DSeabra/headphone_amp/notes/Guitar Headphone Amp/References.md

## Battery charging
- [Microchip MCP73831 Single-Cell Charging Chip](https://cdn.sparkfun.com/datasheets/Components/General%20IC/33244_SPCN.pdf)
	- Sparkfun sells these boards implementing this design:
		- [Single cell, no frills](https://www.sparkfun.com/sparkfun-usb-lipoly-charger-single-cell.html)
		- [Programmable output current single cell](https://www.sparkfun.com/sparkfun-adjustable-lipo-charger.html)
- Sparkfun Lithium-Ion [400mAh pouch](https://www.sparkfun.com/lithium-ion-battery-400mah.html)
- Sparkfun Lithium-Ion [950mAh pouch](https://www.sparkfun.com/lithium-ion-battery-850mah.html)
- Sparkfun ["LiPower" Buck/Boost](https://www.sparkfun.com/lipower-boost-converter.html)

- Adafruit [Universal USB / DC / Solar Lithium Ion/Polymer charger - bq24074](https://www.adafruit.com/product/4755)

# BQ24074 Design Notes

Enable settings
![[Pasted image 20260809201506.png]]

~CHG behavior: 280K pull-down but do NOT leave this disconnected!
