DSeabra/headphone_amp/notes/Guitar Headphone Amp/Charts/pot-taper.png

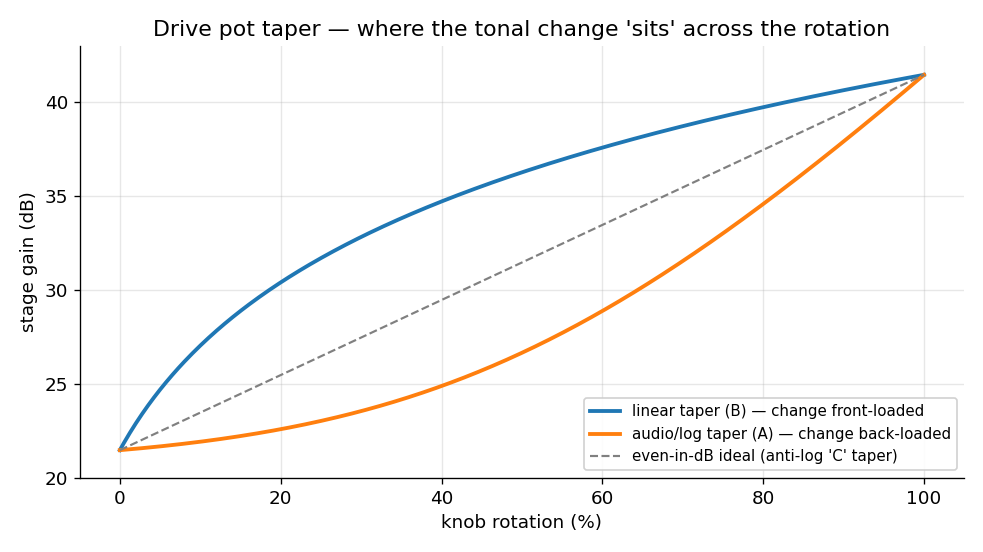
notes/Guitar Headphone Amp/Charts/pot-taper.png
