DSeabra/headphone_amp/notes/Guitar Headphone Amp/Guitar-Headphone-Amp-Theory-of-Operation.md

---
title: Guitar Headphone Amp — Theory of Operation & Tuning Guide
project: pocket guitar headphone amp (rev A)
status: design in progress
tags: [electronics, analog, guitar, distortion, app-note]
---

# Guitar Headphone Amp — Theory of Operation & Tuning Guide

> [!abstract] What this document is
> A working explanation of *why* each part of the amp is shaped the way it is, and *which knobs (literal and component) change what*. It is meant to be read alongside the schematic, so that tuning rev A is informed guessing rather than blind swapping. Values given are **starting points** anchored to the Tube-Screamer (TS) gain-stage lineage — the most-measured drive circuit in guitar electronics — chosen so you tune *from* a known-good baseline.

---

## 1. System overview

The signal path is deliberately split by **impedance**: a FET-input stage where the source impedance is high (the guitar), and a bipolar-input driver where it is low (the headphones). Everything runs off a single boosted 9 V rail with a synthesized mid-rail so the op-amps see a symmetric ±4.5 V about the audio "ground."

Full system block diagram

```mermaid
flowchart TB
    G["guitar<br/>(passive pickup)"] --> IN["1/4&quot; TRS jack"]
    IN --> DRV["OPA1678-A<br/>DRIVE stage<br/>(hi-Z in + gain + clip)"]
    DRV --> REC["OPA1678-B<br/>recovery / make-up gain"]
    REC --> MV["master volume<br/>(pot → mid-rail)"]
    MV --> BL["OPA1622-L<br/>unity buffer"]
    MV --> BR["OPA1622-R<br/>unity buffer"]
    BL --> CL["coupling cap L<br/>220 µF polymer"]
    BR --> CR["coupling cap R<br/>220 µF polymer"]
    CL --> HP["3.5 mm TRS<br/>tip = L / ring = R<br/>(32 Ω ×2)"]
    CR --> HP

    subgraph PWR [power]
      direction LR
      USB["USB-C"] --> CHG["power-path charger"] --> SYS["SYS node"]
      CELL["Li-ion cell"] --- CHG
      SYS --> BST["boost → 9 V"] --> SPL["TLE2426<br/>rail splitter"]
      SPL --> MID["virtual GND = 4.5 V"]
    end

    MID -.mid-rail ref.-> DRV
    MID -.mid-rail ref.-> REC
    MID -.vol return + OPA1622 GND.-> MV
    BST -.+9 V.-> BL
    BST -.+9 V.-> BR
```

> The signal is **mono** through the drive and volume stages, then **fans out to L/R stereo** at the OPA1622 buffers — one per earpiece, each into its own coupling cap and the tip/ring of the TRS jack.

The three most important architectural decisions and their reasons:

- **Boost to a regulated 9 V (no LDO).** A single Li-ion cell sags from 4.2 V to 3.0 V, which is *below* the OPA1622's 4 V floor for most of its life. Regulating *up* keeps every stage in-spec regardless of charge state and gives constant tone (the clip threshold no longer drifts as the battery drains). We picked **9 V specifically for input headroom**: on a 6 V rail the OPA1678's input common-mode window reaches only ~1 V above mid-rail, so a hard humbucker transient can graze the top of it; 9 V opens that to ~2.5 V, clearing the hottest pickups (see §2.8). Both op-amps run to 36 V, so the higher rail changes **no parts**, and it still leaves the boost a clean step-up ratio from any source.
- **Virtual ground instead of a true negative rail.** We only need a *reference* at mid-supply, not a second regulated rail. The TLE2426 synthesizes 4.5 V with milliohm output impedance. Signals are AC-coupled around it, so the headphone return current goes to battery-negative, **not** through the mid-rail — keeping the reference quiet.
- **FET input, bipolar output.** A passive pickup must see ≥ 1 MΩ or it loses treble; a bipolar input's ~µA bias current across 1 MΩ would create ~volts of offset. So the front end is FET (pA bias). The headphone load needs current, which bipolar output stages deliver with low distortion — hence the OPA1622 at the low-impedance end.

> [!info] Companion docs
> Component-level wiring lives in the **[[Connectivity-Netlist]]** companion (per-stage netlist tables). The figure above is `system-block-diagram.svg`.

---

## 2. The input & drive stage — the heart of the tone

This one op-amp does three jobs at once: **present a high-impedance input**, **amplify**, and **clip**. Understanding how those coexist is most of understanding the amp.

### 2.1 Why non-inverting = high-Z for free

In a non-inverting amp the signal enters the **+ input**, which only ever sees the bias resistor to ground. The gain-setting network hangs off the **– input**, on the op-amp's side of the loop. So the pickup never "sees" the gain resistors — input impedance and gain are set at two different nodes and don't trade against each other. That is why we don't need a separate unity-gain buffer: a non-inverting gain stage *is already* a buffer that happens to also amplify.

### 2.2 The feedback network is five parts, not one

```mermaid
flowchart TB
    OUT["op-amp output"] -->|feedback leg| N1["Rf_fixed 51k + DRIVE pot 500k"]
    N1 --> MINUS["– input"]
    DIODES["clip diodes (socketed)"] --- OUT
    DIODES --- MINUS
    CFB["C_fb ~51 pF (high-cut)"] --- OUT
    CFB --- MINUS
    MINUS --> RG["Rg 4.7k"]
    RG --> CG["C_g 47 nF (DC-block + low-cut)"]
    CG --> MID["mid-rail 4.5 V"]
```

| Part | Value (start) | Job |
|---|---|---|
| `R_bias` (R13) | 1 MΩ to mid-rail | high-Z input + DC bias to 4.5 V |
| `C_in` (C2, series at input) | 0.1 µF PEN film | blocks the pickup's DC path so it can't fight the 4.5 V bias; ~1.6 Hz corner |
| `R_series` (R10) + `C_rf` (C3) | 1 kΩ + 470 pF NP0 | defined ~340 kHz RF/hum roll-off + input protection |
| `Rg` (R12) | 4.7 kΩ | lower leg of the gain divider (sets the floor) |
| `C_g` (C5, series with Rg) | 47 nF | **DC-block** (gain = 1 at DC) + **low-cut** ≈ 720 Hz |
| `Rf_fixed` (R11) | 51 kΩ | bounds the top; sets minimum (cleanest) gain |
| `DRIVE pot` (via J4) | 500 kΩ linear | the amount-of-dirt control |
| `C_fb` (C4) | 51 pF NP0 | **high-cut**; tames fizz/RF, aids stability |
| clip diodes (socket J7) | 2× 1N4148 | soft-clip across the feedback leg |

### 2.3 The gain equation

Above the capacitor corners (i.e. in the audio midband), the stage is a plain non-inverting amp:

$$
A_v \;=\; 1 + \frac{R_{f,\text{fixed}} + R_{\text{pot}}}{R_g}
$$

With the starting values:

$$
A_{v,\text{min}} = 1 + \frac{51\text{k}}{4.7\text{k}} \approx 12\;(21\,\text{dB}),
\qquad
A_{v,\text{max}} = 1 + \frac{551\text{k}}{4.7\text{k}} \approx 118\;(41\,\text{dB})
$$

…about a **20 dB drive range**. Turning the pot doesn't change the clip *ceiling* — it changes how hard the signal slams into the diodes, i.e. how much of the waveform gets clipped and how early.

### 2.4 Why there's a capacitor in series with Rg (the load-bearing trick)

`C_g` does two things at once:

1. **DC stability.** At DC the cap is open, so `Zg → ∞` and the gain collapses to **1**. That means the amplified input offset can't slam the output to a rail — the stage passes the 4.5 V bias straight through at unity and only develops gain for AC. Omit this cap and the stage rails on its own offset at high drive.
2. **Bass tightening.** The corner $f = \tfrac{1}{2\pi R_g C_g} = \tfrac{1}{2\pi (4.7\text{k})(47\text{n})} \approx 720\text{ Hz}$ means low frequencies see *less* gain than mids. Thinning the bass **before** the clipper is what keeps distorted chords tight instead of turning to mush (low notes otherwise dominate the clipping and intermodulate).

### 2.5 Why the treble rolls off *more* as you crank

`C_fb` across the feedback creates a high-cut at $f = \tfrac{1}{2\pi R_f C_{fb}}$. But `R_f` grows with the drive pot, so the corner **moves down** as you add gain:

- Drive min: $R_f = 51\text{k} \Rightarrow \approx 61\text{ kHz}$ (bright)
- Drive max: $R_f = 551\text{k} \Rightarrow \approx 5.7\text{ kHz}$ (darker)

This is why a TS-style circuit smooths and thickens as you crank it — it's not a side effect, it's the mechanism. Putting §2.4 and §2.5 together gives the stage's actual frequency response:

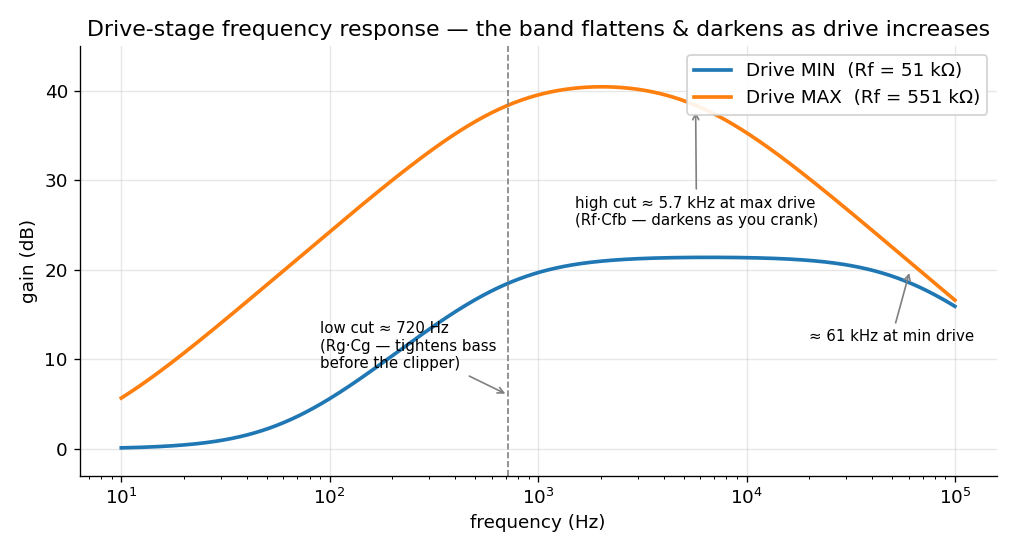
[picture p2: notes/Guitar Headphone Amp/Charts/drive-freq-response.png]
Drive-stage frequency response


Read this as: a **band** whose bottom is fixed at ~720 Hz and whose top slides *down* as you add drive. The midband gain rises (12× → 118×) and the treble corner falls (61 kHz → 5.7 kHz) simultaneously.

### 2.6 How the diodes clip

Two anti-parallel diodes sit across the feedback leg. While the output stays below a diode's forward voltage `Vf`, the diodes are open and the stage has its full gain. Once the output tries to exceed ±`Vf`, a diode conducts, shunting feedback current and dropping the incremental gain toward ~1 — so the output *soft-limits* around ±`Vf`. Because the knee is set by the diode's exponential I–V curve, the corners are rounded, not square: this is **soft clipping**.

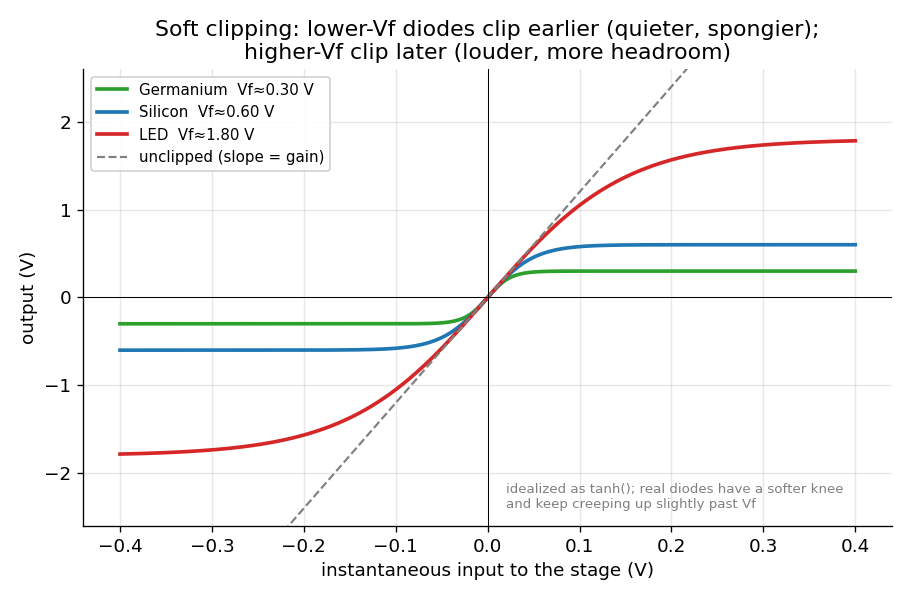
[picture p3: notes/Guitar Headphone Amp/Charts/clipping-transfer.png]
Soft-clip transfer curves for different diode types


The diode's `Vf` sets the clip threshold, which sets both **loudness** and **feel**:

- **Germanium (~0.3 V):** clips earliest → quiet, spongy, "compressed" — least headroom.
- **Silicon 1N4148 (~0.6 V):** the classic TS voice — moderate, singing.
- **LED (~1.8 V):** clips latest → loud, open, more dynamic, closer to the rails.

> [!note] Idealization
> The curves above are drawn as `tanh()` for clarity. Real diodes have a slightly softer knee and keep creeping upward past `Vf` (they never perfectly clamp), which is part of why real clipping sounds "alive." Trust the *ordering and spacing* of the thresholds, not the exact flat tops.

### 2.7 Symmetric vs asymmetric — where the harmonics come from

A **symmetric** clip (equal top and bottom) produces mostly **odd** harmonics — the fizzy, "solid-state" character. Making the clip **asymmetric** (e.g. 1 diode one way, 2 the other, so the two sides clip at different thresholds) adds **even** harmonics, which the ear reads as warmer and more "tube-like."

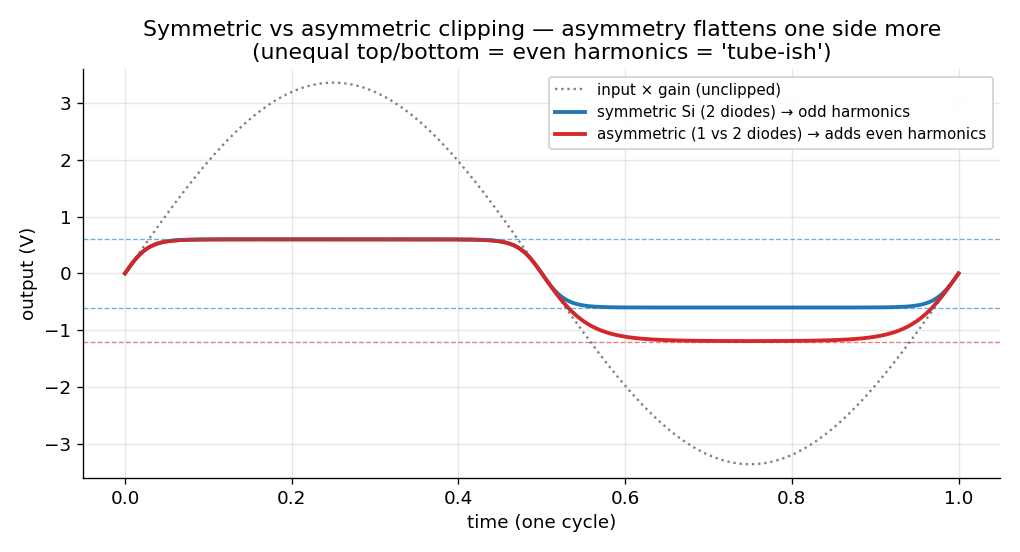
[picture p4: notes/Guitar Headphone Amp/Charts/clipping-waveforms.png]
Symmetric vs asymmetric clipped waveforms


Notice the asymmetric trace flattens one polarity more than the other — that top/bottom inequality *is* the even-harmonic content. This is the single cheapest tone change you can make, and it's why the diodes are socketed.

> [!tip] How the socket actually works (rev A)
> The feedback clipper is a **Mill-Max socket** (`J7`, two rows of four) with a **0 Ω link (`JP1`/`JP2`) populated on each row by default**. Default = one silicon diode per direction → **symmetric**. To go **asymmetric**, pull the 0 Ω on one side and plug a *second* diode into that row's spare holes (two in series → higher Vf that direction). Diode *type* swaps (Si / Ge / Schottky / LED) are just pull-and-replace. The silkscreen marks anode direction per row — mind orientation when inserting an anti-parallel pair.

### 2.8 The optional input soft-limiter (Ihsan's idea)

This is a *different* clipper doing the *opposite* job at the *opposite* end of the stage, and it's worth understanding as its own thing.

The feedback diodes (§2.6) clip the **amplified** signal, *after* gain — that's the distortion voicing. The **input soft-limiter** is an optional second anti-parallel pair at the very **input**, from `FIRST_STAGE_IN` to mid-rail, *before* any gain. It doesn't shape distortion; it **tames the raw guitar transient** — the fast, multi-volt spike a hard-struck humbucker throws before the note settles.

**Why it exists (and why 9 V made it optional rather than mandatory).** The drive op-amp's + input has a finite common-mode window — on 9 V, about 4.5 V ± 2.5 V. A very hot pickup, hit hard, can briefly push the + input past the top of that window. The OPA1678 has no phase reversal, so it just soft-limits gracefully — but you'd rather not lean on that. Clamping the raw input to `VMID ± Vf` keeps the signal inside the CM window *by construction*, and as a bonus adds a gentle **compression** on the loudest peaks — the "smooths the tops even at low drive" behaviour Ihsan described. Because the clamp sits *before* gain, it works at any drive setting, including diodes-out clean-boost mode.

**Vf sets how much it does:**
- **Higher Vf (LED ~1.8 V, or two Si in series ~1.2 V)** — catches only the biggest transients; sits below the ~2.5 V CM ceiling but above normal playing, so it protects the input and lightly compresses without audibly squashing. The "insurance + subtle tamer" setting, and where I'd start.
- **Lower Vf (single Si ~0.6 V, Ge ~0.3 V)** — clamps early and hard; now it's a deliberate **input compressor/limiter** that squashes dynamics before the dirt. A real effect, but a strong one.

**Wiring:** anti-parallel pair from `FIRST_STAGE_IN` (the node *after* `C_in`, i.e. the AC signal riding on mid-rail) to `VMID`. It is **not in the rev-A netlist yet** — provision it as a socketed / DNP pair (same swap logic as the feedback clipper) so you can audition it, or leave the footprint empty. On 9 V you may decide you never need it — which is exactly why it's a provision, not a commitment.

> [!note] Why it's at the input, not the output
> Ihsan's first instinct was to use the *final* drive stage's diodes as the transient tamer. But those feedback diodes clamp relative to the *post-gain* signal and don't care about the rail — so rail voltage can't give them "room" to gently limit an *input* transient. The raw transient only exists *at the input*, so that's where a soft-limiter has to live to do the job he described. Same idea, correct location.

---

## 3. The drive pot taper (corrected — see the working)

An earlier pass through this doc claimed **even-in-dB gain over rotation would need an anti-log ("C") taper**, and that standard audio/log ("A") taper would be back-loaded. That claim doesn't survive actually running the numbers on this circuit's own gain equation (§2.3), and a side-by-side read of the real Bourns PDB181-GTR datasheet confirms the fix. Correcting it here rather than leaving it stand.

**The gain equation, worked as a function of rotation.** From §2.3:

$$A_v(\theta) = 1 + \frac{R_{f,fixed} + R_{pot}(\theta)}{R_g} = 1 + \frac{51\text{k} + R_{pot}(\theta)}{4.7\text{k}}$$

Gain in dB is $20\log_{10}(A_v)$. For that to be **linear in rotation** — i.e. an even-feeling dB sweep — $A_v(\theta)$ itself has to be **exponential** in rotation, which means $R_{pot}(\theta)$ has to be exponential too. Solving for the curve that lands on this circuit's own endpoints (0 Ω → 500 kΩ giving the 12×→118×, 21→41 dB range already quoted in §7):

$$A_v(\theta) \approx 11.85 \times 10^{\theta} \qquad\Rightarrow\qquad R_{pot}(\theta) = 55.7\text{k}\times(10^{\theta}-1)$$

(That the span comes out to almost *exactly* one decade — 21.5 dB to 41.4 dB — is a nice sanity check that this model matches the design's own numbers.) Walking that curve: at 50 % rotation the pot should only be at **24 %** of its resistance; at 75 % it's at **51 %**; it doesn't reach 77 % until 90 % rotation. **That shape — low through most of the sweep, climbing fast only near the end — is exactly the standard audio/log ("A") taper curve**, confirmed directly against the Bourns PDB181-GTR datasheet's own "A Series Tapers" graph (A2/A3: near 0 % through mid-rotation, sweeping up to 100 % only in the last third). It is the **mirror image** of the "C2" taper curve, which starts at 100 % output at zero rotation and decays.

**Where the original claim went wrong:** it correctly described audio taper's own resistance curve ("stays near minimum most of its travel, then arrives in a rush") but then treated that curve as if it *already were* the resulting dB response, rather than recognizing that dB is itself $20\log_{10}(\cdot)$ of that curve. Taking a log of an already-exponential curve is precisely what straightens it into something linear — that's the entire reason audio-taper pots exist for ordinary volume controls, and the same log-cancellation applies here because gain in this feedback topology is (to good approximation) linear in the pot's own resistance, same as voltage is linear in resistance in a plain divider.

**A second, independent reason to avoid "C" taper here:** the datasheet's own pinout diagrams show **A/B taper terminals as 1‑2‑3, and C taper as 3‑2‑1 — physically mirrored.** C is built as the mirror image of A, specifically so it can be wired the conventional way (terminal 1 to the "low" side) and still read out the opposite curve. Since `J4` already wires pin 1 → `FB_RES` (the standard A/B convention), dropping a C-taper part into that same footprint would make the knob run **backwards** — more clockwise rotation would *decrease* gain — independent of the taper-shape question above.

**Corrected recommendation:** for even-in-dB drive, use standard **audio/log taper — Bourns "A2" or "A3"** (e.g. `PDB181-GTR02-504A2`), not C2. The rest of §3's original spirit still holds: neither taper is "more correct" than linear in an absolute sense — **linear (B0)** front-loads the dB change (confirmed by the same derivation: a linear `R_pot(θ)` puts ~74 % of the total dB swing in the first half of rotation) and is the historically-authentic TS choice, while **audio (A)** spreads it evenly. Socket the pot and compare linear vs. A2/A3 by feel; just don't reach for "C" expecting it to be the even-dB option — per the math and the mirrored pinout, it's neither even nor wired the direction you'd want.

---

## 4. Recovery & make-up-gain stage (OPA1678-B)

After the clipper the signal is **small and compressed** — roughly 0.4 V RMS and nearly independent of the drive setting (drive changes *how much* clipping, not the ceiling). This stage restores level so the output buffers have a healthy signal to work with. It's the **second half of the OPA1678 dual**.

### 4.1 Inverting, fixed ~3× gain

Channel A had to be non-inverting for its high-Z input. Channel B is fed by the drive stage's **low-impedance output**, so it doesn't need high-Z — which frees the choice, and we take **inverting** for flexibility (an inverting summing node is the natural place to add a clean/dirty blend or tone shaping in rev B) and simplicity. The gain is **fixed**: the drive knob already sets "how much dirt," so this is set-and-forget make-up gain, not a second control.

$$A_v = -\frac{R_f}{R_{in}} = -\frac{100\text{k}}{33\text{k}} \approx -3.0$$

The polarity inversion is inaudible. Keep `R_in` in the tens of kΩ so it's an easy load on the drive stage while keeping resistor noise sane.

### 4.2 Two things inverting *forces* you to add

Inverting flips where the reference and the DC block live compared to channel A, and both are easy to forget:

1. **Mid-rail goes on the + input.** In an inverting stage the **+ input is the DC reference** — tie it to virtual ground (4.5 V) through `R_ref` (R16, ~100 kΩ). Feedback then pins the – (summing) node to 4.5 V as well, setting the output's DC operating point at mid-rail. (With the FET-input OPA1678, input-bias-current matching barely matters, so `R_ref`'s exact value isn't critical.)
2. **A DC block in series with `R_in`.** The drive stage output sits at 4.5 V DC and so does the summing node — but clipper and offset asymmetries mean it isn't *exactly* 4.5 V, and any mismatch × 3 would push this stage's output off-center and eat headroom. A cap in series with `R_in` (R15) blocks that hand-off error and sets the low corner: `C_inB` (C6) 0.1 µF with `R_in` 33 kΩ → **~48 Hz** (passes all guitar bass).

A small `C_fbB` (~100 pF across `R_f`; `C7`, **populated in rev A**) is cheap HF/stability insurance, same as channel A (`C4`).

### 4.3 Optional hard clip (DNP)

Two anti-parallel diodes provisioned **DNP** from this stage's **output to mid-rail** give a *hard* clipper — clamping to ±Vf regardless of the op-amp, a harsher flavor stacked on channel A's soft clip. Place them at the **output (a fixed-level node, before the master volume)** so the clip threshold stays constant; after the volume pot it would move with the knob. Probably never populated — cheap experiment insurance, in keeping with socketing the tone-critical parts.

> The master volume pot and the hand-off to the L/R output buffers are covered in **§5.3** — a single mono audio-taper pot after this stage, feeding both buffers, returned to mid-rail so the wiper self-biases them.

---

## 5. Output stage — dual OPA1622 as L/R buffers

The small-signal op-amps upstream can't source the tens of milliamps a 32 Ω headphone wants; the OPA1622 is a bipolar-input part built exactly for that (high output current, very low distortion into 32 Ω, happy on the 9 V rail). Its bipolar input would be wrong at the 1 MΩ front end (bias-current offset) but is ideal here, looking back into the low output impedance of the volume stage.

### 5.1 Mono in, stereo out

The guitar is mono, but headphones have two drivers and the 3.5 mm **TRS** jack carries tip (L) and ring (R) over a common sleeve. So the OPA1622 dual becomes **two channels fed the same post-volume signal** — one drives tip, one drives ring, each through its own coupling cap into its own 32 Ω earpiece. Two buffers each into 32 Ω also beats one buffer into a paralleled 16 Ω: half the per-channel current and half the coupling-cap value for the same low-end corner. The path is therefore mono all the way to the OPA1622, then fans out to L/R.

### 5.2 Unity-gain followers (why not gain here)

Each channel is a **unity-gain follower**, because its job is *current*, not voltage — the gain already happened upstream. Unity also avoids a single-supply trap: a non-inverting *gain* stage would multiply the 4.5 V mid-rail bias and slam a rail unless you AC-couple the feedback; a follower's output DC simply equals its input DC (4.5 V), idling at mid-rail with no extra parts. The OPA1622 is unity-gain stable, so this is clean.

> [!note] The clean ceiling is the input range, not the output swing
> In a follower the + input tracks the output, and the OPA1622's common-mode range is (V–)+1.5 to (V+)–1, i.e. **1.5 V to 8 V** on this rail. So the clean limit is 4.5 V ± 3 V ≈ **2.1 V RMS** (~140 mW into 32 Ω) — far more than headphones need, and set by the *input* CM range, not the rail-to-rail output. If you ever wanted more, a small AC-coupled gain relieves it (the + input then swings only a fraction of the output).

### 5.3 Master volume placement

A single mono **audio-taper** pot sits *after* OPA1678-B and *before* the two buffers, its wiper feeding both. Tie the pot's low end to the **mid-rail (4.5 V)**, not 0 V: then both ends of the track sit at 4.5 V DC, the wiper is always at 4.5 V DC, only the AC is attenuated — so the buffer inputs stay correctly biased with **no extra coupling cap**. (Return it to 0 V instead and the wiper DC would droop with rotation, forcing another blocking cap.) Unlike the drive pot, this is a plain resistive divider feeding a fixed downstream load, not a resistor buried in a gain-setting feedback network — so standard audio/log taper (Bourns "A2"/"A3") gives an even-feeling loudness sweep directly, no correction needed the way §3 required for the drive pot.

Because both ends of the track sit at the same DC potential, no DC current flows through the pot regardless of its total resistance, and the A2 taper's curve shape (output % vs. rotation %) is a ratio independent of total resistance — so the resistance value itself is a fairly free choice here. **500 kΩ (Bourns PDB181-GTR01-504A2) works as well as the originally-specified 10 kΩ**: it's actually a *lighter* load on OPA1678-B's output than 10 kΩ would have been, and the resulting higher wiper output impedance (~125 kΩ worst-case at mid-rotation) still only forms a low-pass corner in the tens-of-kHz range with realistic trace/wire capacitance — well outside audio range for the short internal wiring in a pocket-sized enclosure. Only worth re-checking if the pot ends up on a long, unshielded external cable run.

### 5.4 Output coupling caps — polymer, not bipolar

Corner into 32 Ω is $f = \tfrac{1}{2\pi RC}$: **220 µF → ~23 Hz**, flat well below the low-E (~82 Hz). We use the **Würth 875105244013** — a 220 µF / 10 V aluminum-**polymer** SMD can, 30 mΩ ESR, 6.3 × 5.8 mm.

> [!warning] Correction from an earlier instinct
> A *bipolar* electrolytic is the generic-audio reflex for a coupling cap, but it's wrong for **this** board on two counts: bipolar electrolytics are almost all through-hole radial cans (fighting an SMT, plug-in build), and the reverse-bias condition that motivates them barely occurs here. The cap idles at **+4.5 V forward bias**, and at audio frequencies its impedance is tiny next to the 32 Ω load, so almost all the AC drops across the *load*, not the cap — it just sits near +4.5 V with small ripple. Reverse-biasing it would need volts of sub-bass AC below the ~23 Hz corner, which a guitar simply doesn't produce. So a **polarized** polymer is both appropriate and better (lower ESR, no dry-out, SMD, small). 30 mΩ in series with 32 Ω is ~0.1% — inaudible; skip the film bypass.

Orient **+ toward the amp** (the +3 V node). Add a **bleed resistor (~100 kΩ–1 MΩ)** from the cap's load side to 0 V so it pre-charges/discharges gently — half the turn-on-thump fix.

### 5.5 The GND-pin decision (and why it drives the EN scheme)

Tie the OPA1622 **GND pin to the virtual ground (mid-rail), not 0 V.** That pin references the internal compensation cap that gives the part its high PSRR, and it wants a low-impedance, low-noise reference — which the 7.5 mΩ mid-rail is, precisely because we kept the headphone return on 0 V. Referencing GND to the noisy 0 V/return rail instead would partly waste the PSRR you're paying for.

The consequence: EN's thresholds (≤ 0.78 V shutdown, ≥ 0.82 V enable) are referenced to that GND pin, so with GND at 4.5 V, **enable now means EN ≥ ~5.32 V**.

### 5.6 EN soft-start (default-populated)

`R_en` from **V+ (9 V)** to EN, `C_en` from **EN to 0 V**. At power-on EN starts at 0 V and rises as $V_{EN}(t)=9\,(1-e^{-t/\tau})$, $\tau=R_{en}C_{en}$; it crosses the 5.32 V enable point at

$$t_{enable} = \tau\,\ln\!\left(\tfrac{9}{9-5.32}\right) \approx 0.89\,\tau$$

— almost exactly one time constant. **R_en = 100 kΩ, C_en = 2.2 µF → ~200 ms delay** (τ ≈ 220 ms), comfortably after the rails and big caps settle, imperceptible as an annoyance. Keep R_en stiff (~100 kΩ, not 1 MΩ): the EN bias current (~3 µA) across it is only ~0.3 V of droop, so EN parks near 8.7 V — solidly enabled. A **Schottky across R_en** (anode at EN) does nothing on power-up but, on power-*down*, dumps C_en into the collapsing rail and yanks EN into shutdown fast — muting the amp *before* the rails sag into pop territory. Gentle on, immediate off.

### 5.7 Housekeeping (from the datasheet)

- **Thermal pad → V– (0 V)** with a copper pour + vias (heat path *and* internal reference).
- **0.1 µF at each supply pin** to 0 V, plus a bulk cap.
- Worst-case continuous dissipation rises modestly on the 9 V rail but is still only a few hundred mW per channel into 32 Ω — you'll never sustain that into headphones, so the VSON pad copes easily.
- **Provision, don't commit, for cable stability:** a series-R (start 0 Ω) + optional Zobel (R–C to 0 V) footprint per output, decided on the bench. Keep any series R tiny — even 10 Ω into 32 Ω hurts damping/level, which matters for low-impedance IEMs.

---

## 6. Tuning guide

Everything structural (topology, rail, op-amp choices) is fixed. The **flavor** lives in a handful of socketed/swappable parts. Tune in this order — biggest perceptual effect first.

### 6.1 What each handle does

| Handle | Turn it ___ | Effect |
|---|---|---|
| **Diode type** (Vf) | lower Vf (Ge) | earlier clip, quieter, spongier, less headroom |
| | higher Vf (LED) | later clip, louder, more open/dynamic |
| **Diode symmetry** | asymmetric (1 vs 2) | adds even harmonics → warmer, "tube-ish" |
| **`C_g`** (Rg series cap) | bigger | more bass into clipper → looser, fuzzier, thicker |
| | smaller | tighter, more mid-focused, "cuts through" |
| **`C_fb`** (feedback cap) | bigger | darker, especially at high drive; kills fizz |
| | smaller | brighter/edgier at high drive |
| **`Rf_fixed`** | bigger | raises *minimum* gain (min-drive is dirtier) |
| **Drive pot taper** | linear vs audio (A2/A3) | moves where the usable range sits in rotation — see §3 for the corrected math; avoid "C" taper here |

### 6.2 Suggested order of attack

1. **Get it working clean first.** Populate with **no diodes** (open sockets) → verify the stage is a clean amp with the expected gain and no rail-slamming or oscillation. This proves the bias, the `C_g` DC-block, and stability before you add nonlinearity.
2. **Add symmetric silicon (2× 1N4148).** This is the reference voice. Confirm soft clipping on a scope and by ear.
3. **Swap diode types** (Ge, LED, mixed) and **try asymmetric** — this is the biggest tonal fork.
4. **Adjust `C_g`** to set bass-into-clipper (start 47 nF; try 22 nF for tighter, 100 nF for looser).
5. **Adjust `C_fb`** only if the top end feels wrong at high drive (start 51 pF).
6. **Decide the pot taper** last, once you know where your favorite drive settings land — linear vs. audio (A2/A3), per §3.

### 6.3 Symptom → fix

| Symptom | Likely cause | Try |
|---|---|---|
| Output stuck at a rail, no signal | `C_g` missing / wrong; amplified offset | confirm `C_g` in place; check + input sits at 4.5 V |
| Farts out / flabby on low notes | too much bass into clipper | **smaller `C_g`** (e.g. 22 nF) |
| Thin / buzzy, no body | too little bass, or clip too hard/bright | bigger `C_g`; higher-Vf diodes; bigger `C_fb` |
| Harsh / fizzy top | ultrasonic content amplified | **bigger `C_fb`**; verify RF input filter |
| Not enough grit at full drive | gain range too low | larger drive pot or smaller `Rg` |
| All the action crammed at "10" | taper mismatch | try the other taper — linear vs. audio A2/A3 (§3) |
| Motorboating / oscillation | layout / feedback / supply bypass | add/verify `C_fb`; tighten supply decoupling; check inductor placement |

---

## 7. Starting values (rev A baseline)

```
Rail:      9 V boost · virtual ground 4.5 V (TLE2426) · both op-amps on V+/VMID
Input:     C_in(C2) 0.1µF PEN film · R_bias(R13) 1MΩ · RF: R_ser(R10) 1kΩ + C_rf(C3) 470pF NP0
Gain leg:  Rg(R12) 4.7kΩ · C_g(C5) 47nF
Feedback:  Rf_fixed(R11) 51kΩ · DRIVE pot 500kΩ LINEAR (Same Sky, via J4) · C_fb(C4) 51pF NP0
           — socket to compare vs. audio taper A2/A3 (Bourns PDB181-GTR02-504A2); avoid "C" taper (§3)
Clipper:   socket J7 (Mill-Max, 2 rows×4) · 2×1N4148 default (SYMMETRIC)
           JP1/JP2 0Ω shorts populated · pull one + add diode = ASYMMETRIC
Recovery:  R_in(R15) 33kΩ · Rf_B(R14) 100kΩ (gain ~3×, inverting) · C_inB(C6) 0.1µF (~48Hz)
           R_ref(R16) 100kΩ→mid-rail · C_fbB(C7) 100pF (populated) · hard-clip D2/D3→mid-rail (DNP)
Volume:    audio taper pot (Bourns PDB181-GTR01-504A2, 500kΩ) via J6 · low end → mid-rail (wiper self-biases)
           — 500kΩ chosen over the original 10kΩ spec for parts availability; see §5.3, no functional downside here
Input lim: DNP/socket provision, FIRST_STAGE_IN → mid-rail (see §2.8)
Result:    gain 12×–118× (21–41 dB) · low-cut ~720Hz
           high-cut 61kHz→5.7kHz across drive · soft clip ±~0.6V
```

> [!tip] Post-clip level
> After silicon clipping the signal is small and compressed (~0.4 V RMS) and roughly independent of drive. The **recovery stage (OPA1678-B) therefore wants make-up gain, not attenuation** — that's the inverting ~3× stage in **§4**, feeding the master volume and L/R buffers.

---

## 8. Further reading

- **ElectroSmash — "Tube Screamer Analysis"** — component-by-component teardown of exactly this gain/clip topology; the definitive reference for the numbers here.
- **ElectroSmash — "LM386 Analysis"** and the *runoffgroove* "Ruby" — for the lo-fi power-amp lineage if you ever want a discrete/IC output alternative.
- **TI OPA1622 datasheet (SBOS727)** §8.2 & Fig. 48 — headphone-driver application + the EN anti-thump divider.
- **TI OPA1678/OPA1656 datasheets** — the "no phase reversal" behavior and (in the OPA1656 doc) an actual guitar-input reference schematic.
- **TI TLE2426 datasheet (SLOS098)** — rail-splitter noise-reduction pin behavior.
- **Bourns PDB181-GTR Series datasheet** — 17 mm guitar potentiometer; taper charts (A2/A3, B0, C2) and the mirrored A/B-vs-C pinout referenced in §3.
