DSeabra/headphone_amp/headphone_amp.pdf

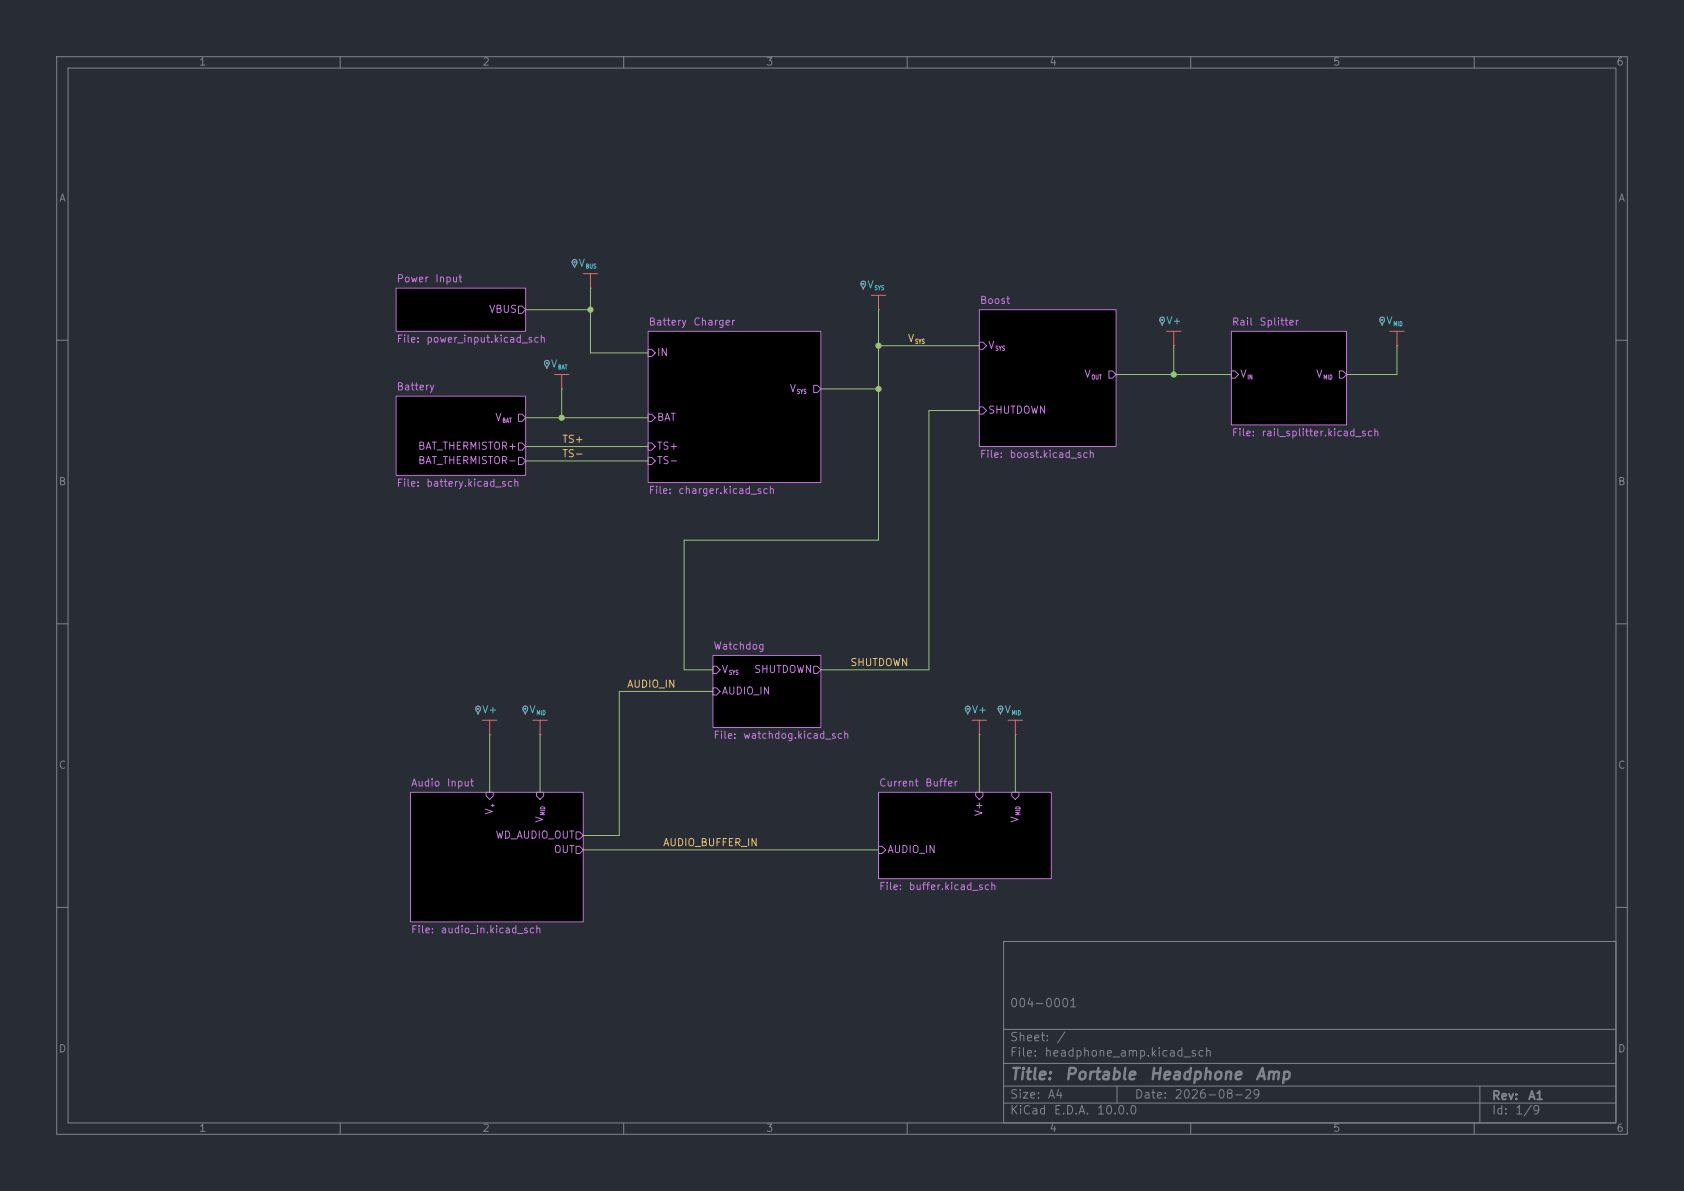
[picture p5: page 1]

Current Buffer File: buffer.kicad_sch BAT_THERMISTOR+
BAT_THERMISTOR-

Sheet: /
D Date: 2026-08-29 KiCad E.D.A. 10.0.0
File: headphone_amp.kicad_sch
Title: Portable Headphone Amp

Size: A4 | Rev: A1

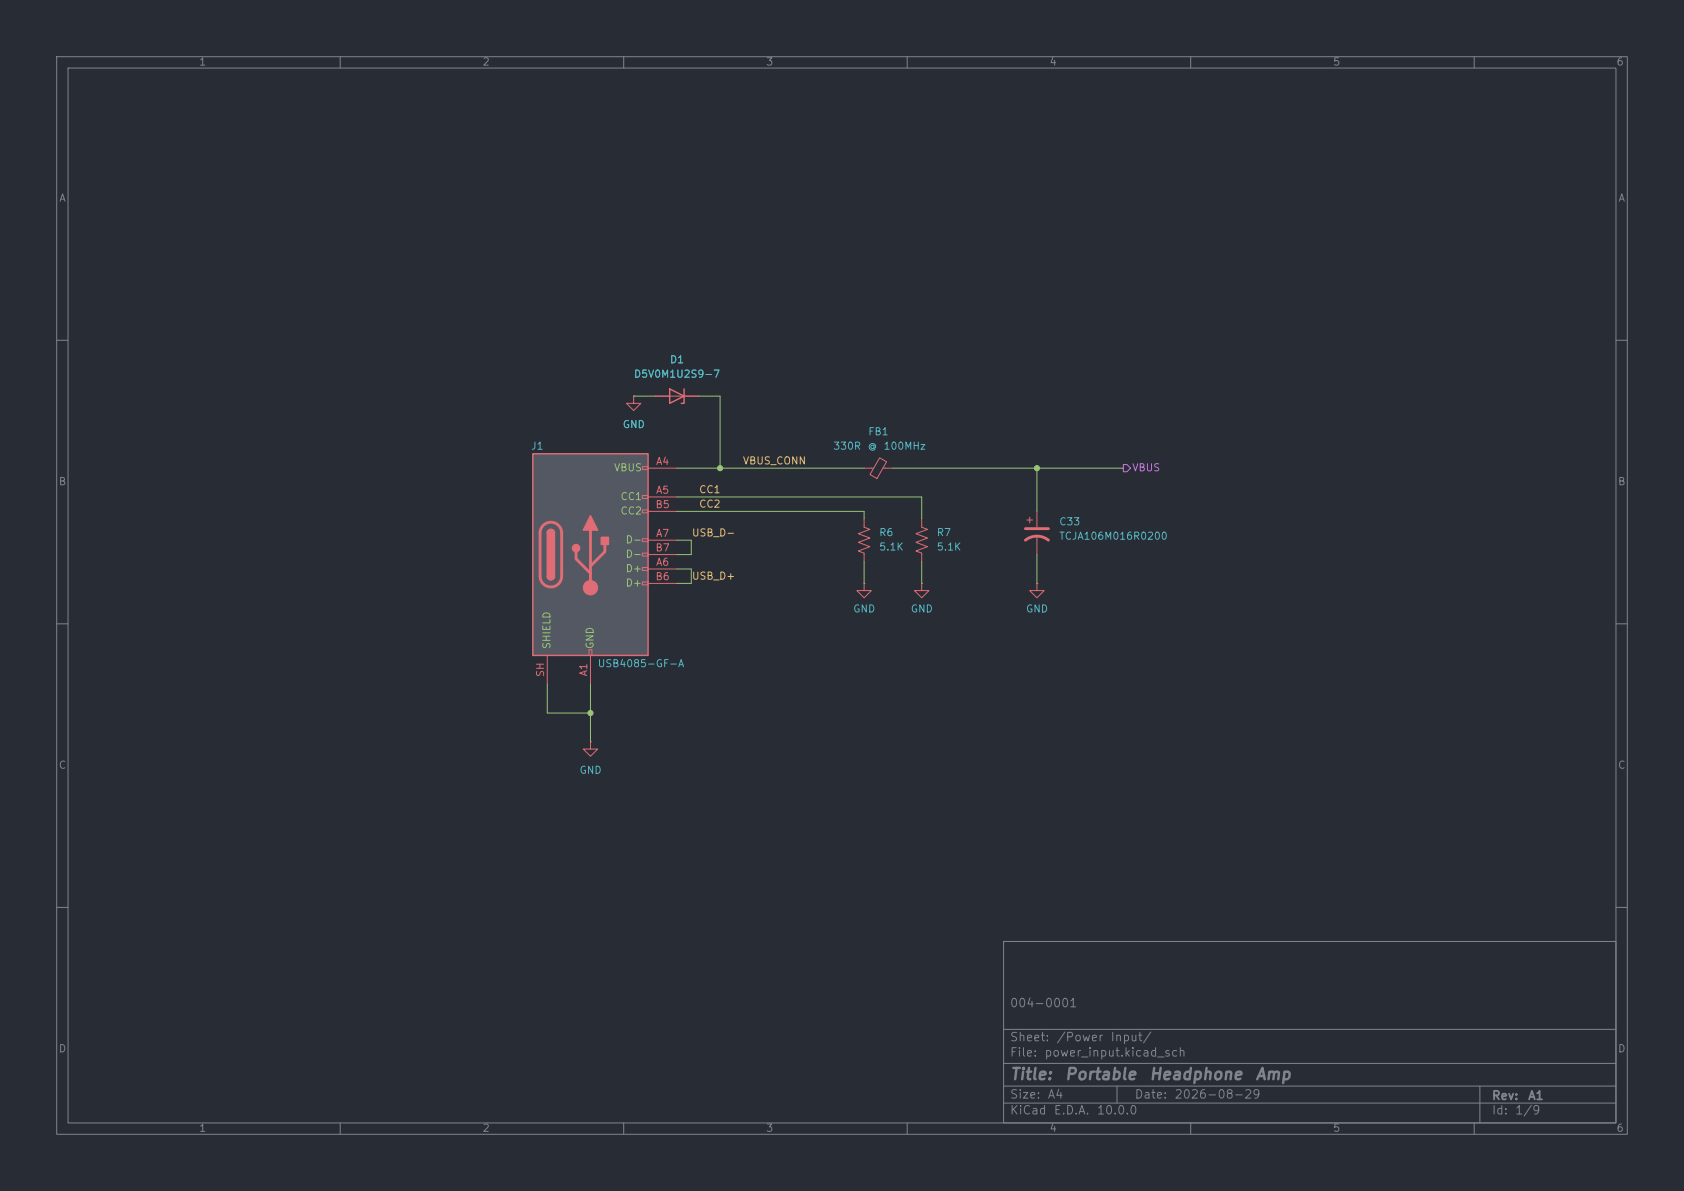
[picture p6: page 2]

Sheet: /Power Input/
D Date: 2026-08-29 KiCad E.D.A. 10.0.0
File: power_input.kicad_sch
Title: Portable Headphone Amp

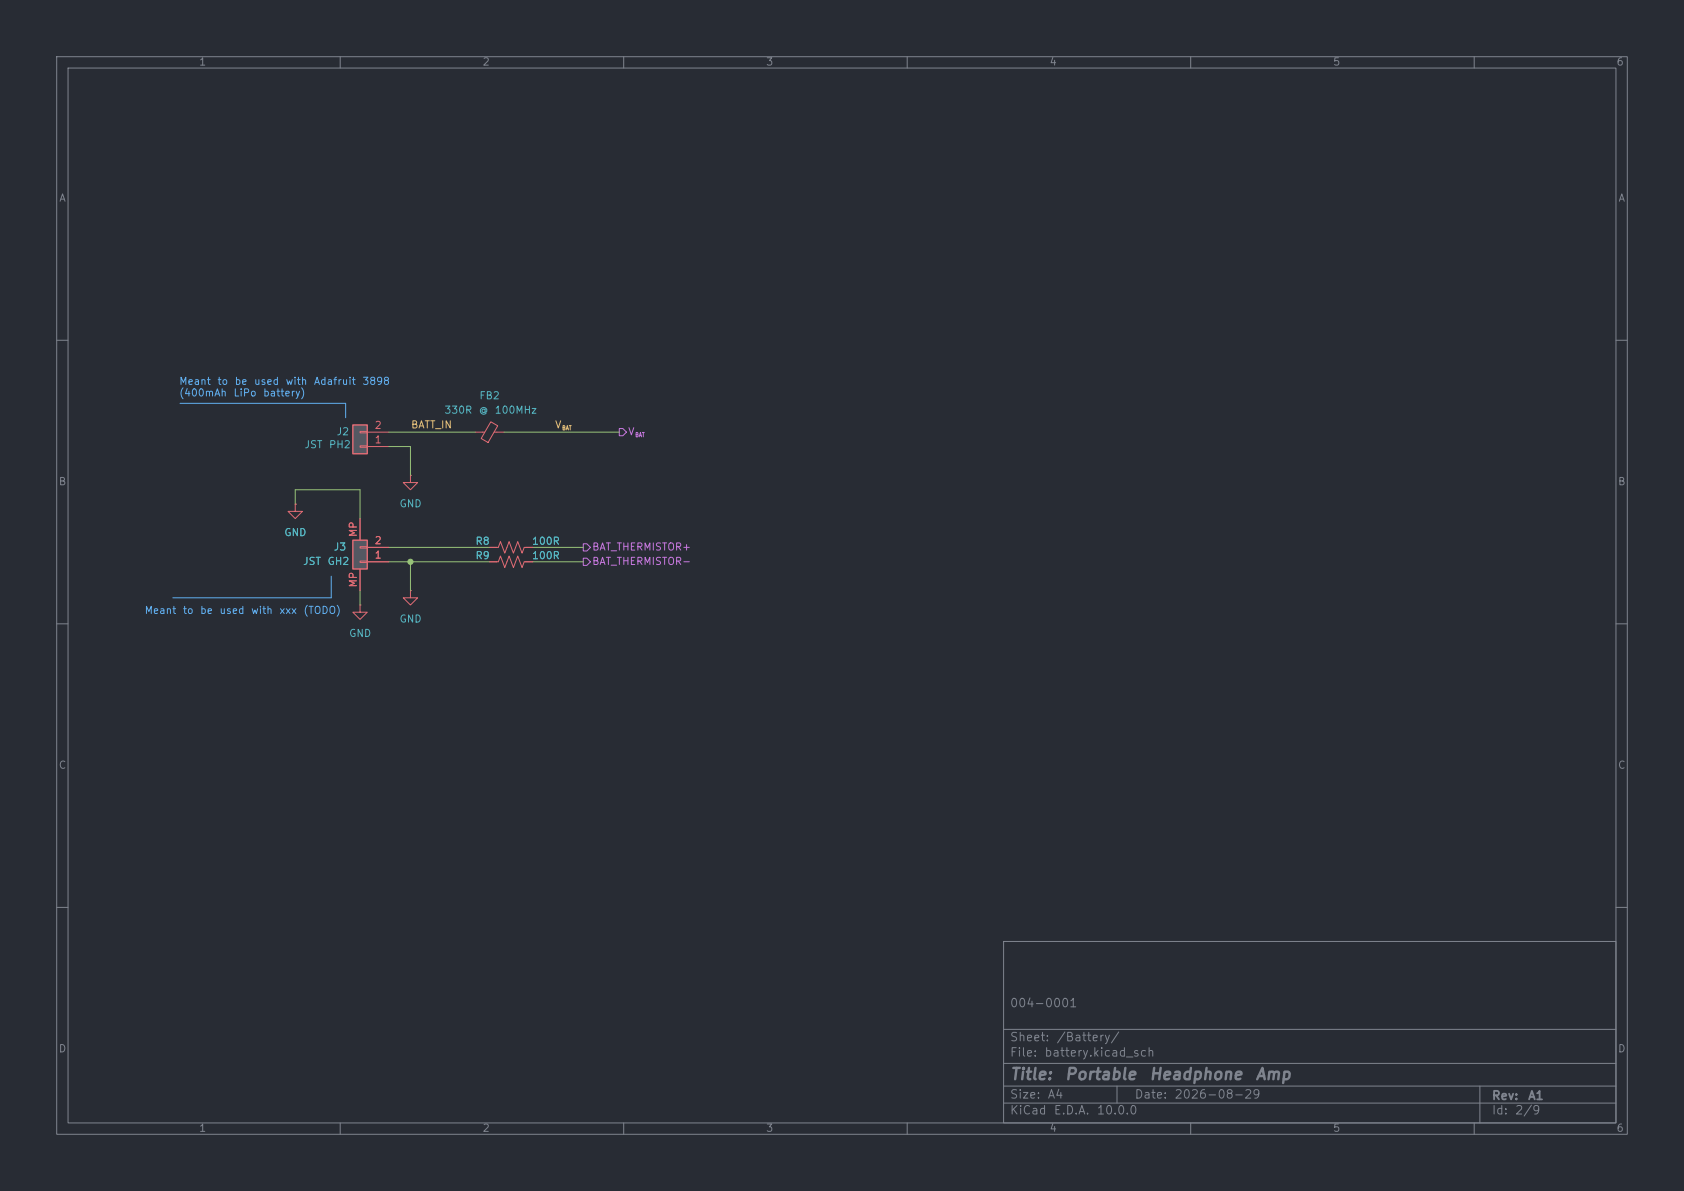
[picture p7: page 3]

Meant to be used with xxx (TODO) GND

Sheet: /Battery/
D Date: 2026-08-29 KiCad E.D.A. 10.0.0
File: battery.kicad_sch
Title: Portable Headphone Amp

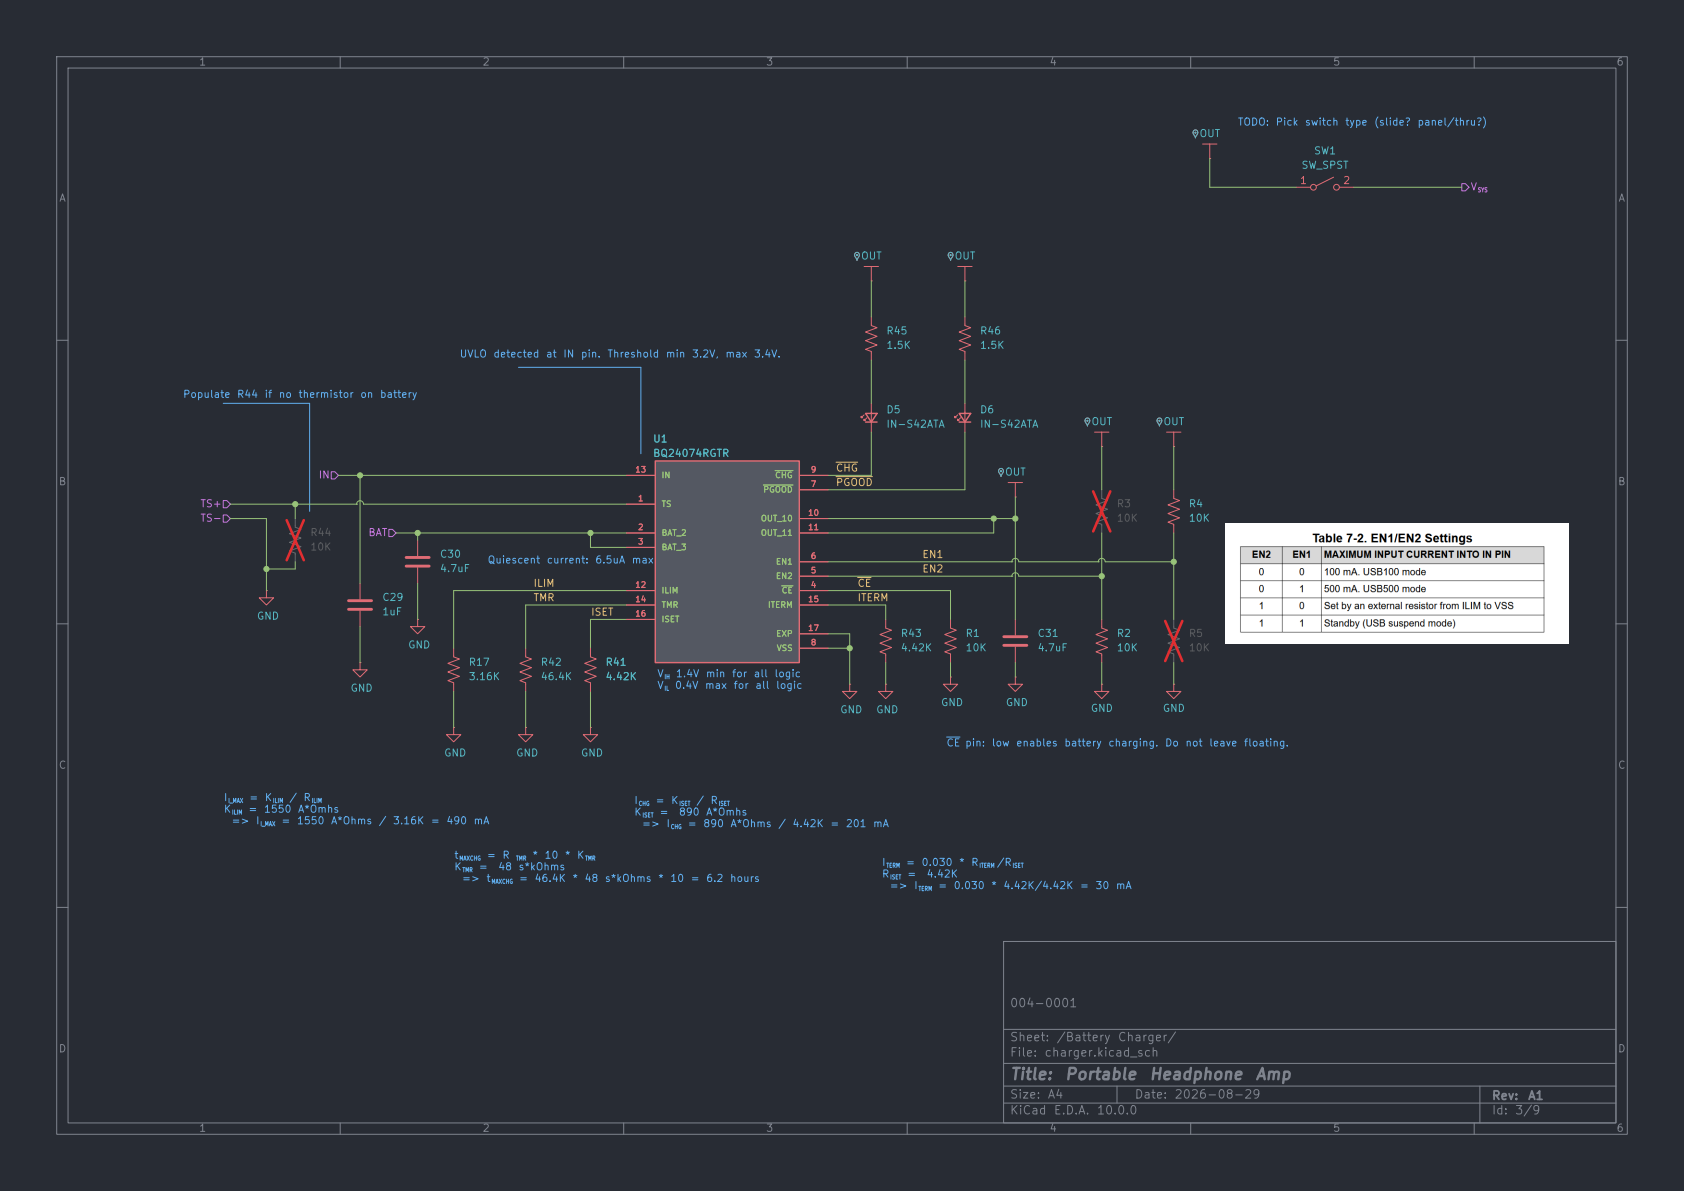
[picture p8: page 4]

TODO: Pick switch type (slide? panel/thru?)
SW_SPST GND

UVLO detected at IN pin. Threshold min 3.2V, max 3.4V. V IH 1.4V min for all logic

t MAXCHG = R TMR * 10 * KTMR KTMR = 48 s*kOhms => t MAXCHG = 46.4K * 48 s*kOhms * 10 = 6.2 hours R41

V IL 0.4V max for all logic

I CHG = KISET / RISET KISET = 890 A*Omhs => I CHG = 890 A*Ohms / 4.42K = 201 mA

I TERM = 0.030 * RITERM /RISET RISET = 4.42K => I TERM = 0.030 * 4.42K/4.42K = 30 mA

Sheet: /Battery Charger/
D Date: 2026-08-29 KiCad E.D.A. 10.0.0
File: charger.kicad_sch
Title: Portable Headphone Amp

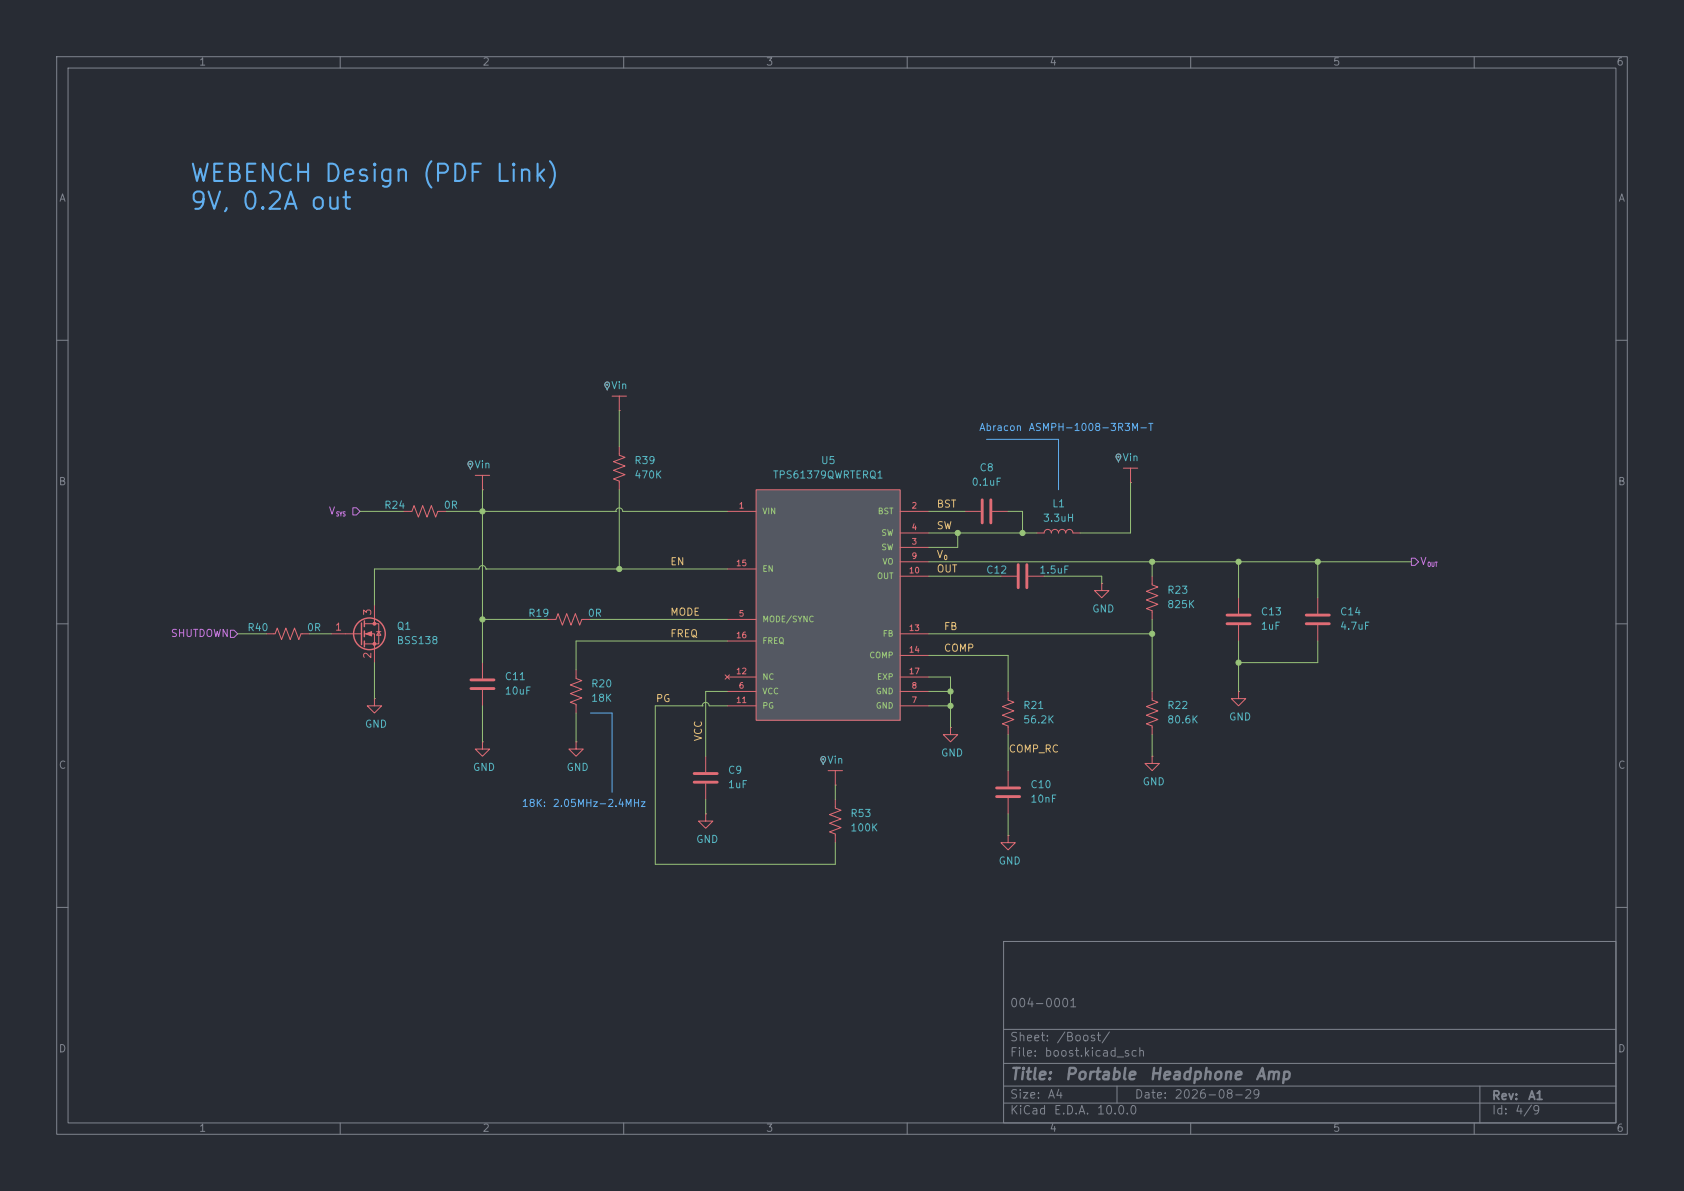
[picture p9: page 5]

Sheet: /Boost/
D Date: 2026-08-29 KiCad E.D.A. 10.0.0
File: boost.kicad_sch
Title: Portable Headphone Amp

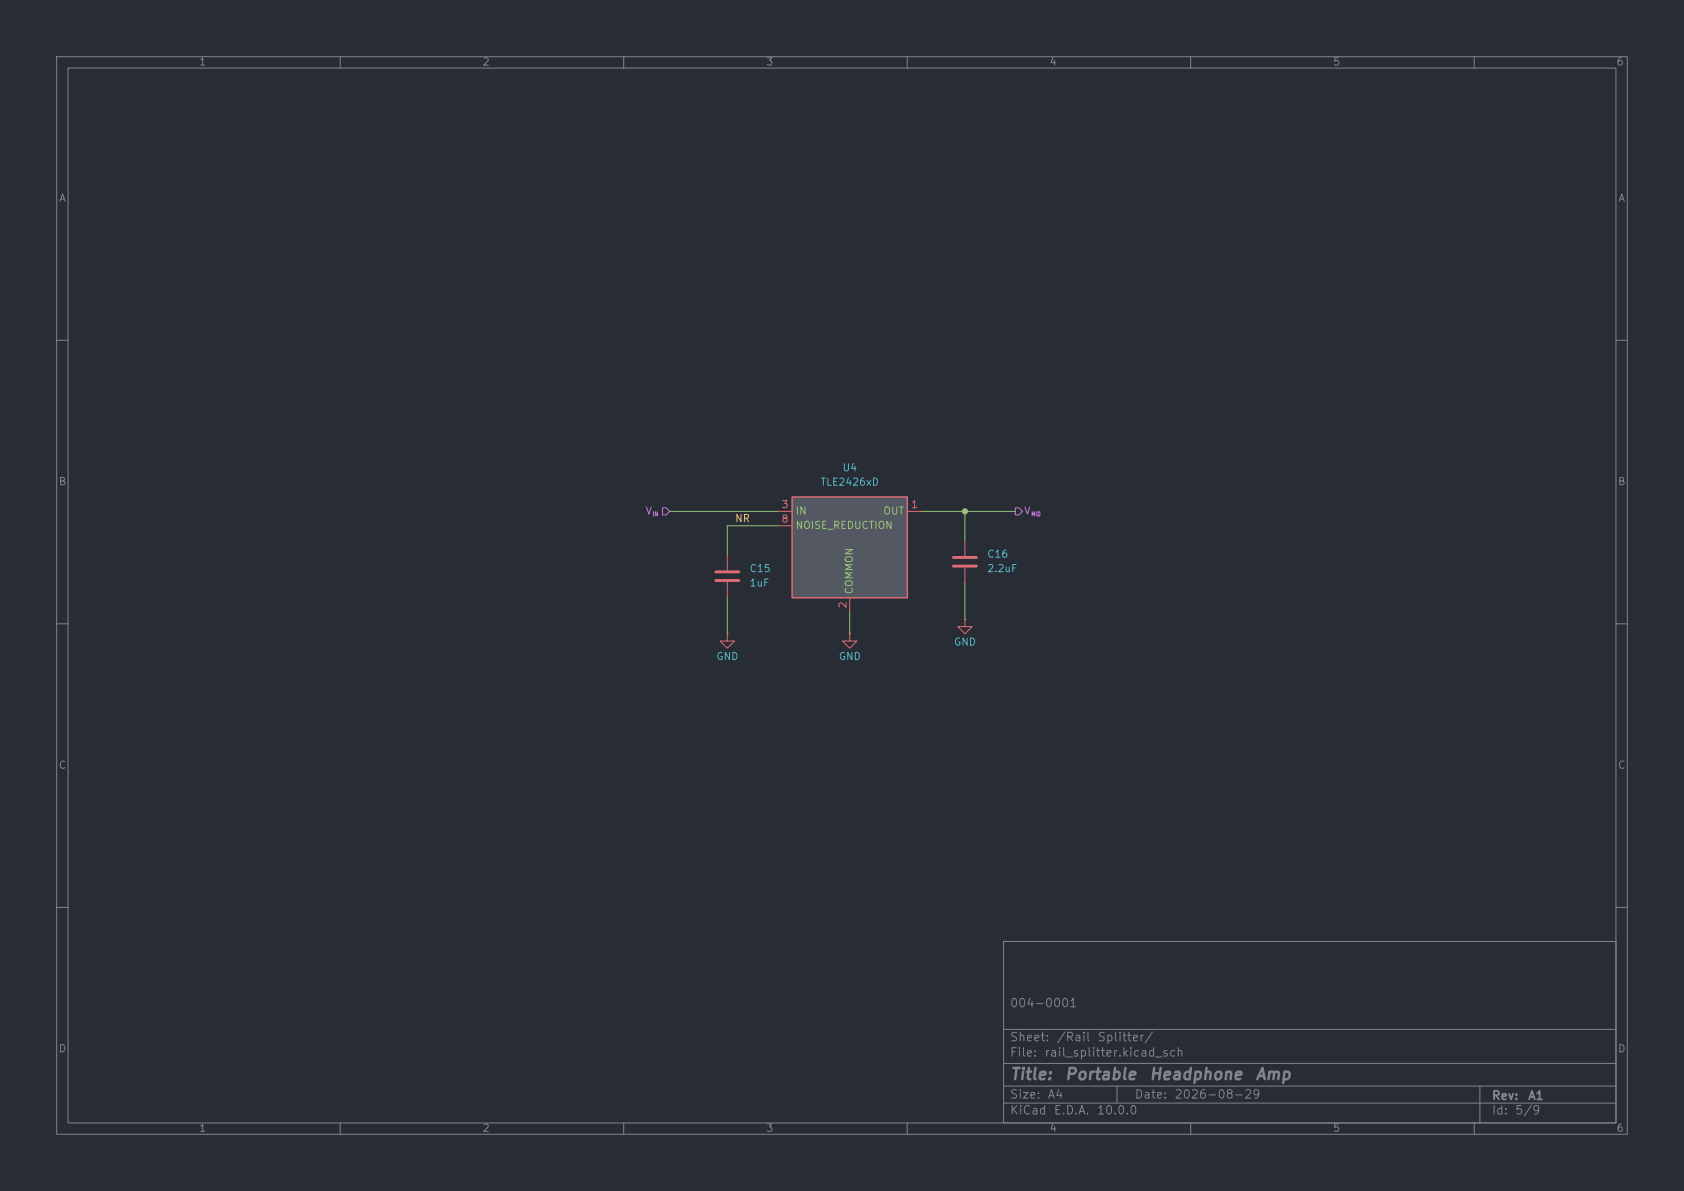
[picture p10: page 6]

Sheet: /Rail Splitter/
D Date: 2026-08-29 KiCad E.D.A. 10.0.0
File: rail_splitter.kicad_sch
Title: Portable Headphone Amp

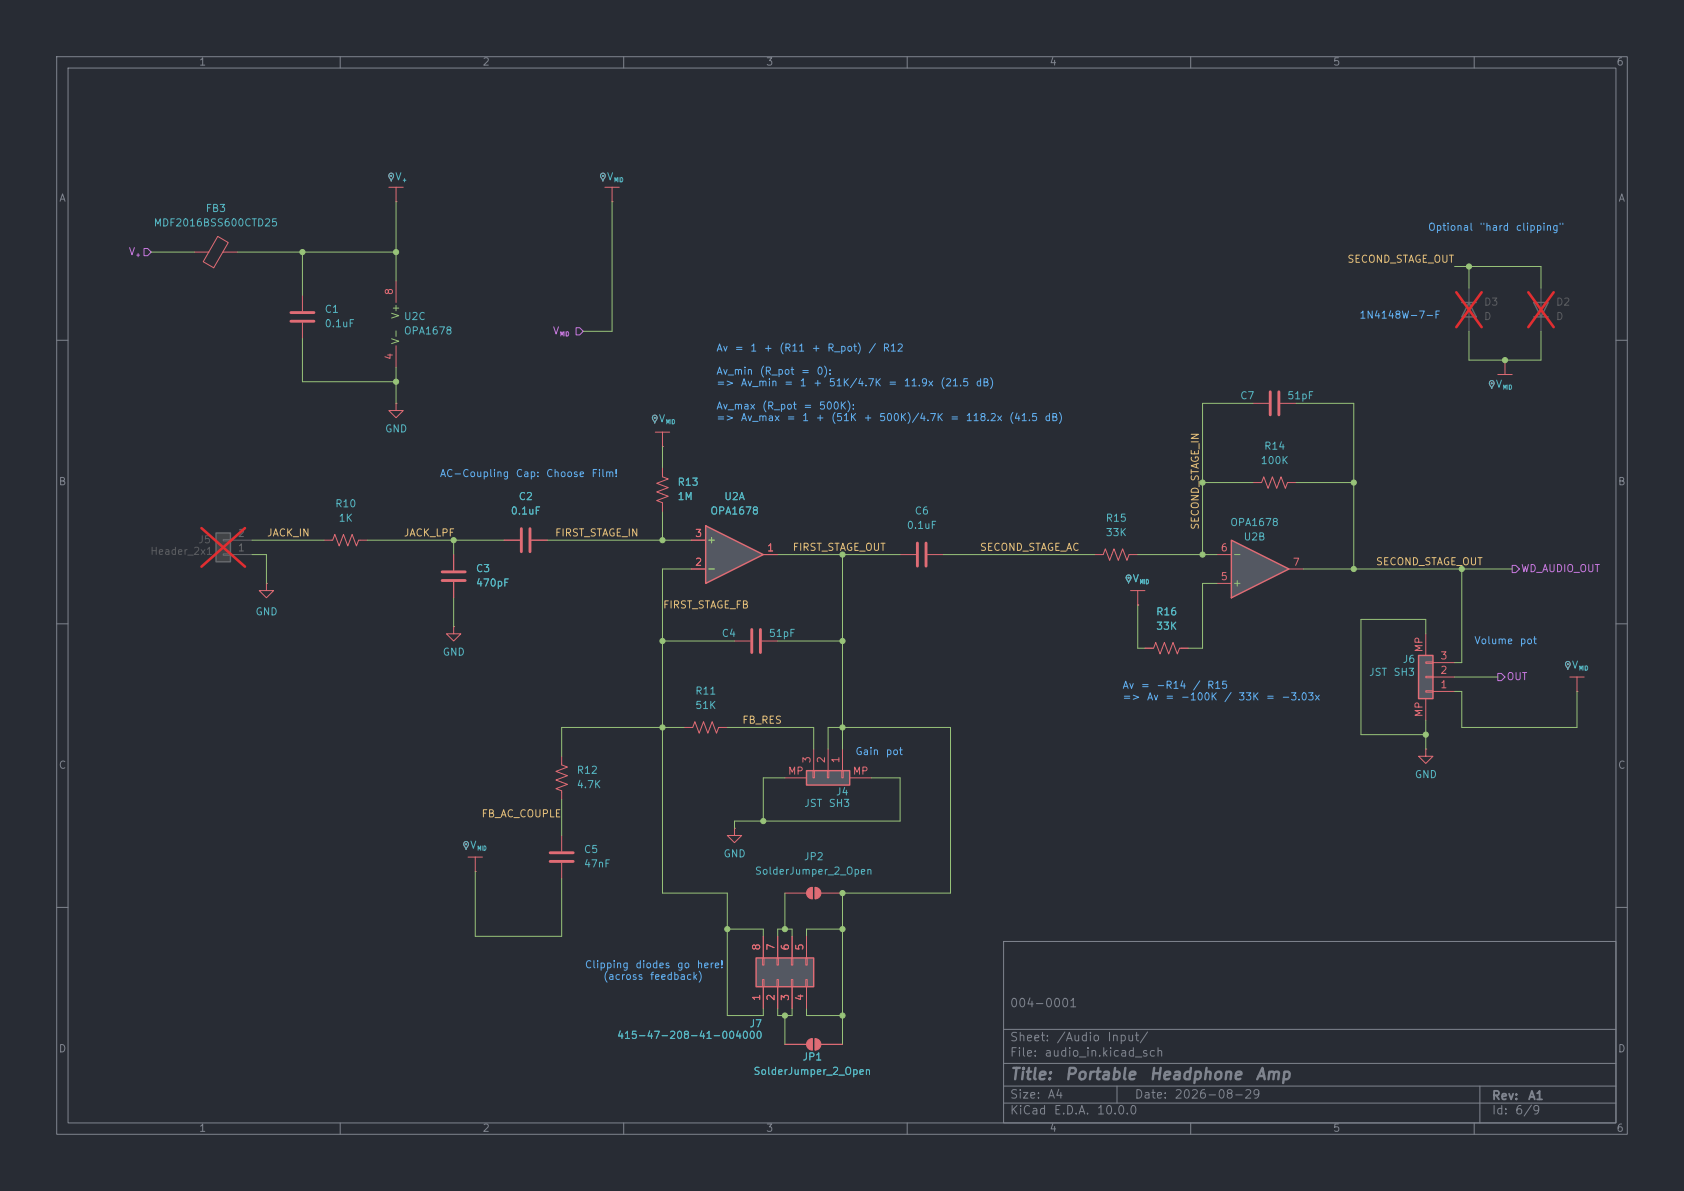
[picture p11: page 7]

Av = -R14 / R15 => Av = -100K / 33K = -3.03x Clipping diodes go here! (across feedback)

Sheet: /Audio Input/
D Date: 2026-08-29 KiCad E.D.A. 10.0.0
File: audio_in.kicad_sch
Title: Portable Headphone Amp

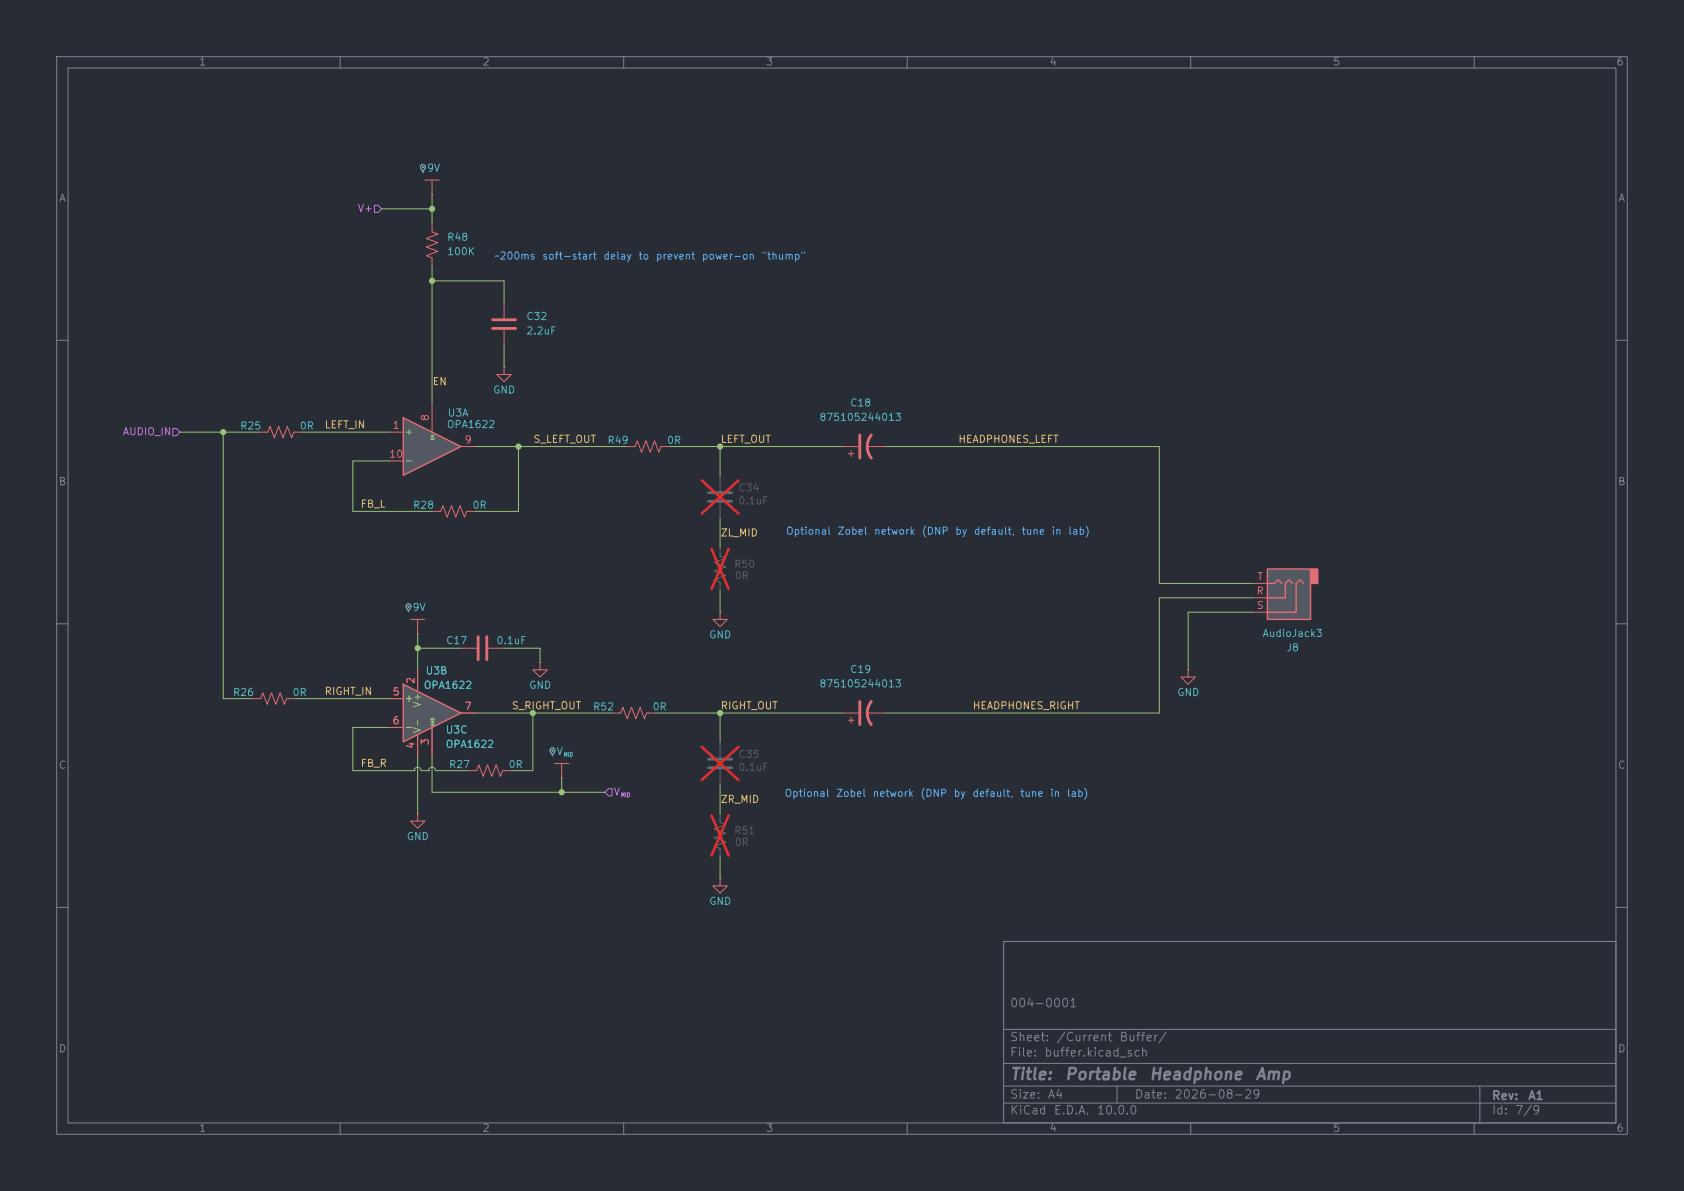
[picture p12: page 8]

~200ms soft-start delay to prevent power-on "thump"

Optional Zobel network (DNP by default, tune in lab) U3C OPA1622 V+

Sheet: /Current Buffer/
D Date: 2026-08-29 KiCad E.D.A. 10.0.0
File: buffer.kicad_sch
Title: Portable Headphone Amp

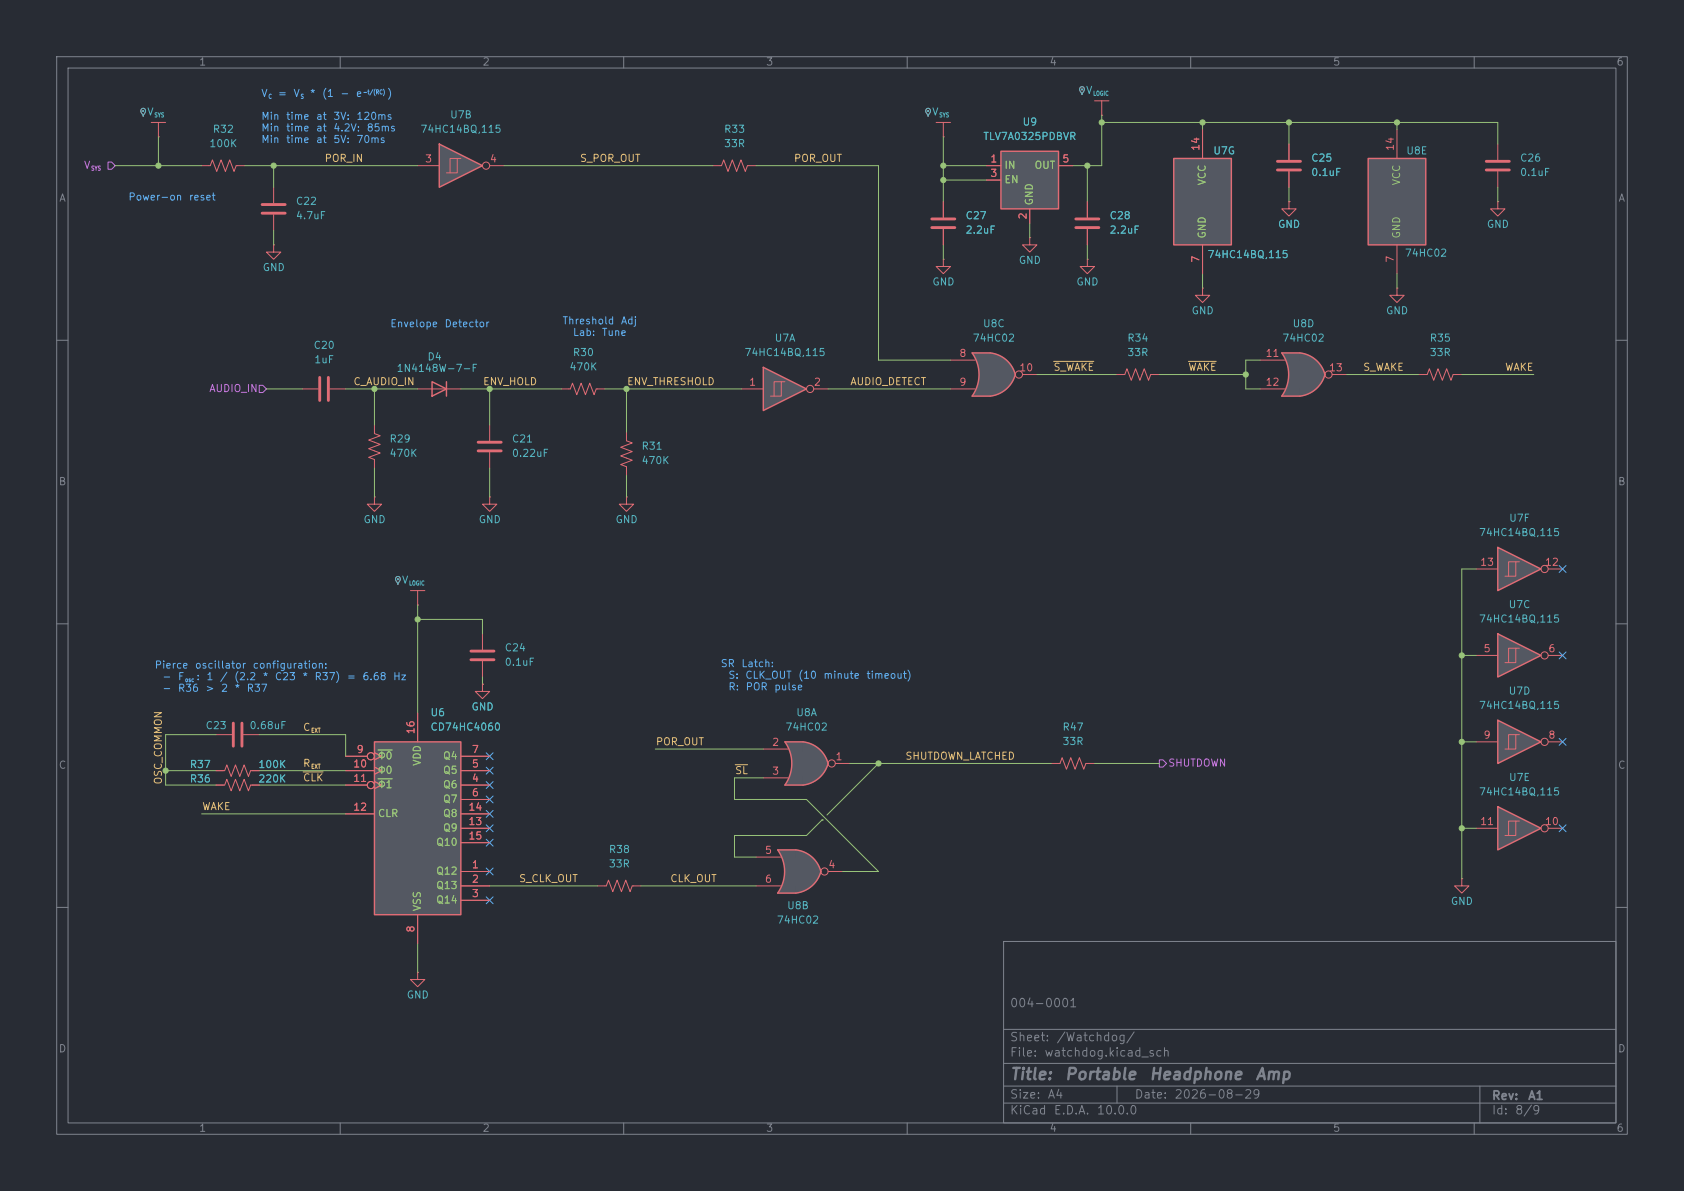
[picture p13: page 9]

Sheet: /Watchdog/
D Date: 2026-08-29 KiCad E.D.A. 10.0.0
File: watchdog.kicad_sch
Title: Portable Headphone Amp
