DSeabra/headphone_amp/headphone_amp.kicad_pcb

## KiCad design headphone_amp.kicad_pcb (2026-10-21)

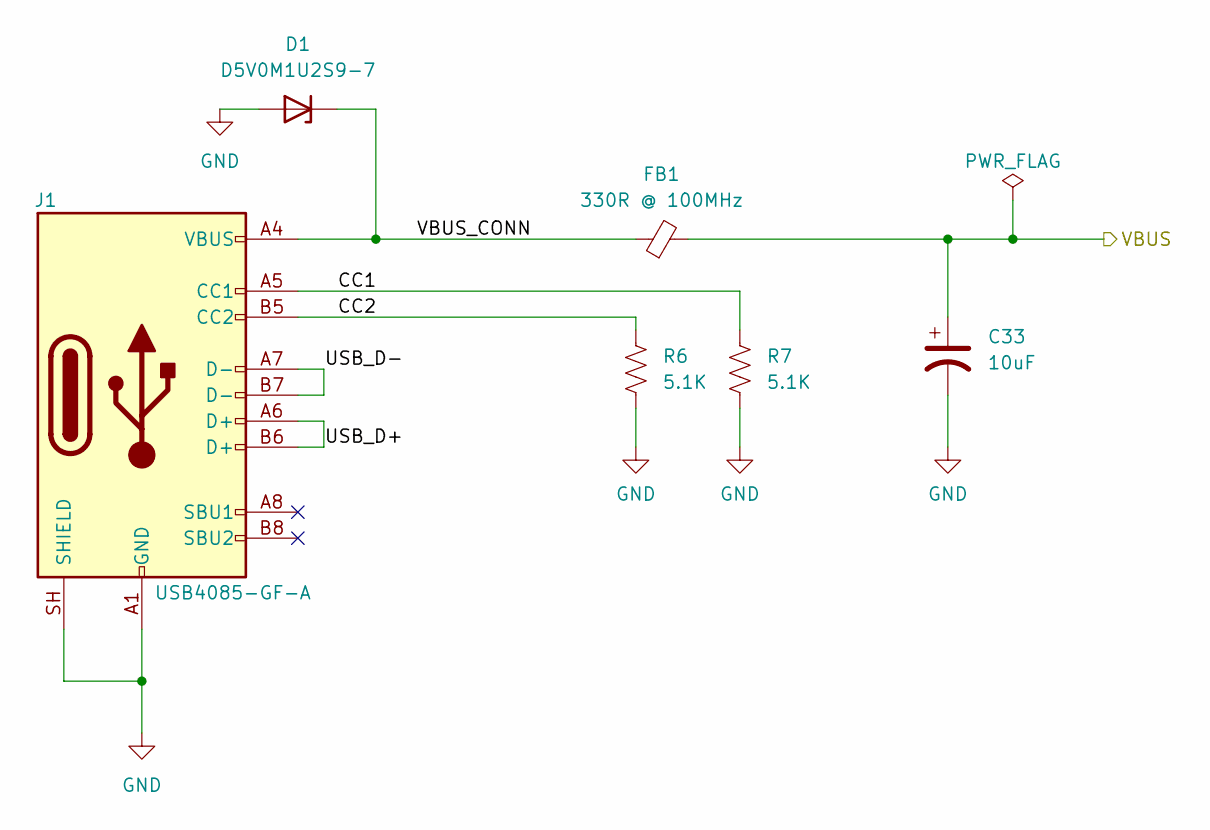
[picture p14: schematic power_input.kicad_sch, ${PROJECT_NAME}]

Parts:
C33: 10uF; TCJA_AVX
D1: D5V0M1U2S9-7; D_SOD-923
FB1: 330R @ 100MHz; L_0402_1005Metric
J1: USB4085-GF-A; USB_C_Receptacle_GCT_USB4085
R6, R7: 5.1K; R_0402_1005Metric

Connections:
/Power Input/CC1: J1.A5 (CC1), R7.1
/Power Input/CC2: J1.B5 (CC2), R6.1
/Power Input/USB_D+: J1.A6 (D+), J1.B6 (D+)
/Power Input/USB_D-: J1.A7 (D-), J1.B7 (D-)
/Power Input/VBUS_CONN: D1.1 (K), FB1.1, J1.A4 (VBUS), J1.A9 (VBUS), J1.B4 (VBUS), J1.B9 (VBUS)
/V_{BUS}: C33.1, FB1.2; also elsewhere on the board
GND: C33.2, D1.2 (A), J1.A1 (GND), J1.A12 (GND), J1.B1 (GND), J1.B12 (GND), J1.SH (SHIELD), R6.2, R7.2; also elsewhere on the board

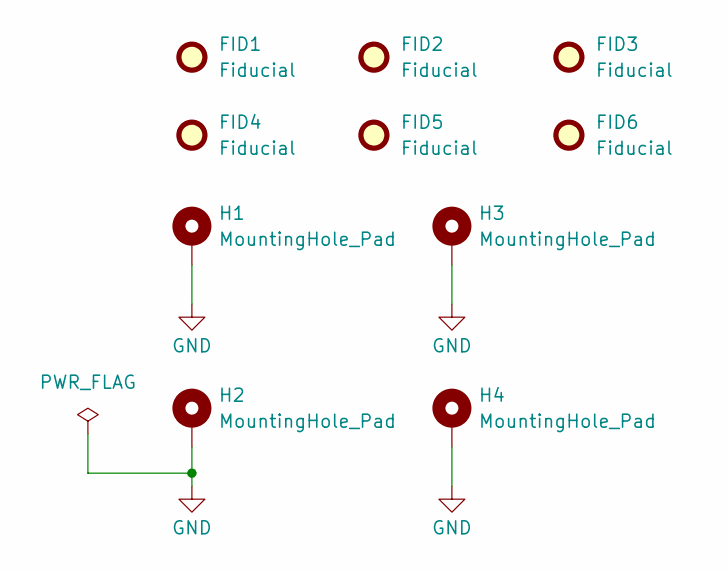
[picture p15: schematic mechanical.kicad_sch, ${PROJECT_NAME}]

Parts:
FID1, FID2, FID3, FID4, FID5, FID6: Fiducial; Fiducial_1.5mm_Mask3mm
H1, H2, H3, H4: MountingHole_Pad; MountingHole_3.2mm_M3_DIN965_Pad

Connections:
GND: H1.1 (1_1), H2.1 (1_1), H3.1 (1_1), H4.1 (1_1); also elsewhere on the board

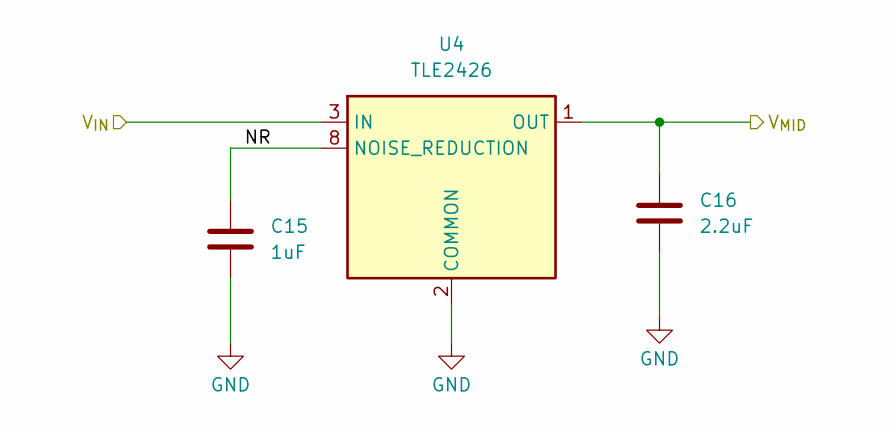
[picture p16: schematic rail_splitter.kicad_sch, ${PROJECT_NAME}]

Parts:
C15: 1uF; C_0603_1608Metric
C16: 2.2uF; C_0603_1608Metric
U4: TLE2426; SOIC-8_3.9x4.9mm_P1.27mm

Connections:
/Rail Splitter/NR: C15.2, U4.8 (NOISE_REDUCTION)
/V+: U4.3 (IN); also elsewhere on the board
/V_{MID}: C16.2, U4.1 (OUT); also elsewhere on the board
GND: C15.1, C16.1, U4.2 (COMMON); also elsewhere on the board

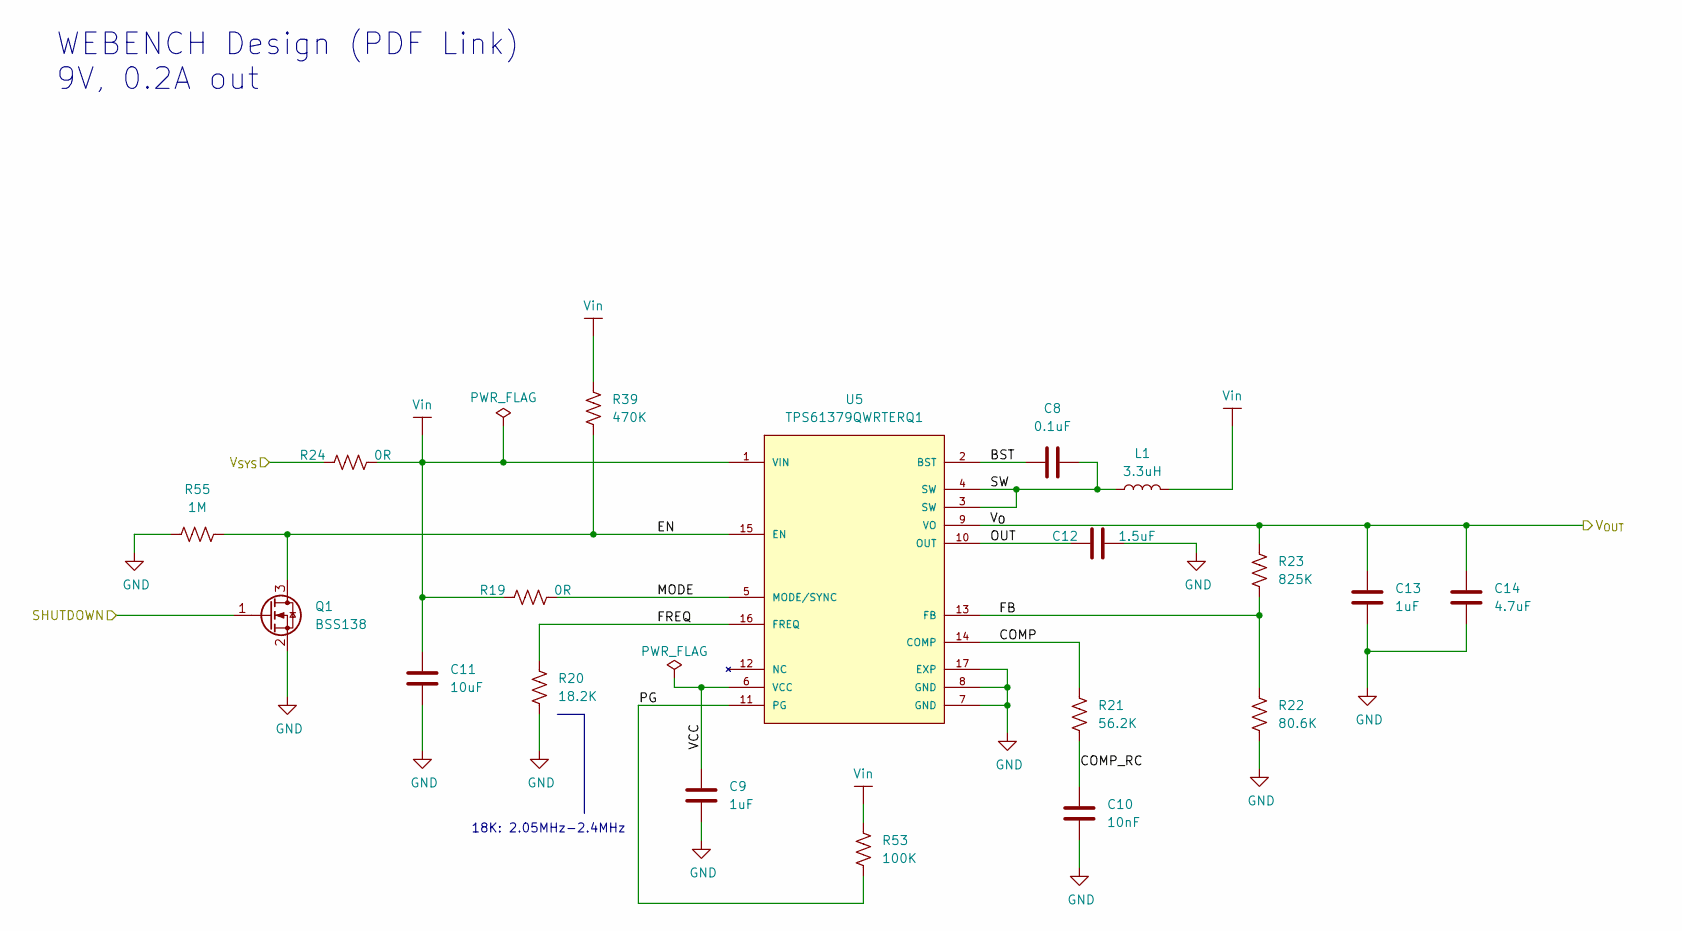
[picture p17: schematic boost.kicad_sch, ${PROJECT_NAME}]

Parts:
C8: 0.1uF; C_0402_1005Metric
C9, C13: 1uF; C_0402_1005Metric
C10: 10nF; C_0402_1005Metric
C11: 10uF; C_0805_2012Metric
C12: 1.5uF; C_0805_2012Metric
C14: 4.7uF; C_0603_1608Metric
L1: 3.3uH; L_1008_2520Metric
Q1: BSS138; SOT-23
R19, R24: 0R; R_0402_1005Metric
R20: 18.2K; R_0402_1005Metric
R21: 56.2K; R_0402_1005Metric
R22: 80.6K; R_0402_1005Metric
R23: 825K; R_0402_1005Metric
R39: 470K; R_0402_1005Metric
R53: 100K; R_0402_1005Metric
R55: 1M; R_0402_1005Metric
U5: TPS61379QWRTERQ1; VREG_TPS61379QWRTERQ1

Connections:
/Boost/BST: C8.1, U5.2 (BST)
/Boost/COMP: R21.2, U5.14 (COMP)
/Boost/COMP_RC: C10.1, R21.1
/Boost/EN: Q1.3 (D), R39.2, R55.2, U5.15 (EN)
/Boost/FB: R22.2, R23.1, U5.13 (FB)
/Boost/FREQ: R20.2, U5.16 (FREQ)
/Boost/MODE: R19.2, U5.5 (MODE/SYNC)
/Boost/OUT: C12.1, U5.10 (OUT)
/Boost/PG: R53.1, U5.11 (PG)
/Boost/SHUTDOWN: Q1.1 (G); also elsewhere on the board
/Boost/SW: C8.2, L1.1, U5.3 (SW), U5.4 (SW)
/Boost/VCC: C9.1, U5.6 (VCC)
/Boost/Vin: C11.2, L1.2, R19.1, R24.2, R39.1, R53.2, U5.1 (VIN)
/V+: C13.2, C14.2, R23.2, U5.9 (VO); also elsewhere on the board
/V_{SYS}: R24.1; also elsewhere on the board
GND: C9.2, C10.2, C11.1, C12.2, C13.1, C14.1, Q1.2 (S), R20.1, R22.1, R55.1, U5.7 (GND), U5.8 (GND), U5.17 (EXP); also elsewhere on the board

Notes on the sheet:
WEBENCH Design (PDF Link) 9V, 0.2A out
18K: 2.05MHz-2.4MHz

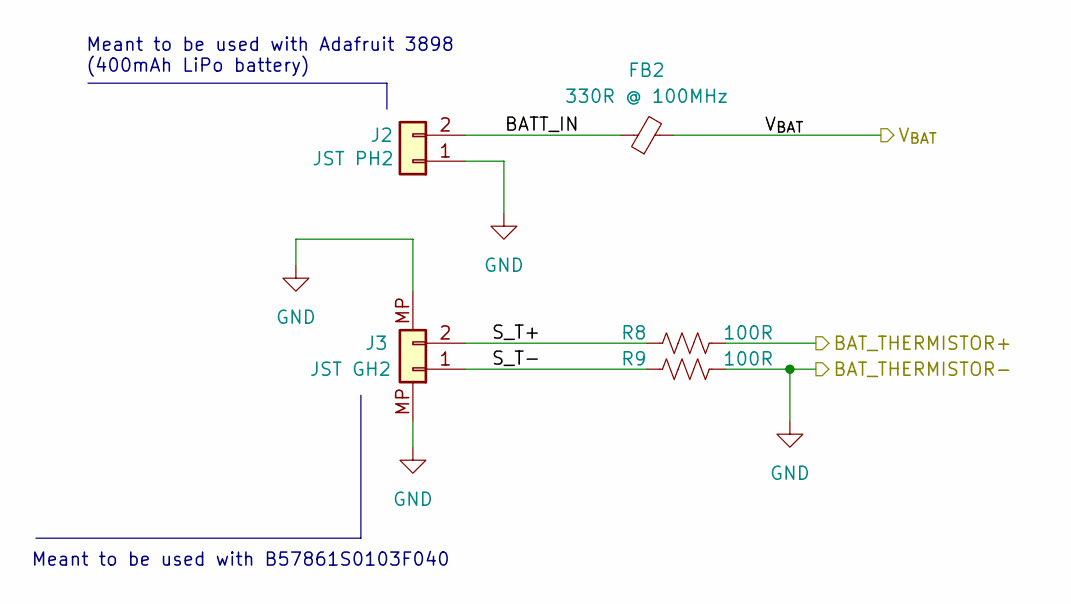
[picture p18: schematic battery.kicad_sch, ${PROJECT_NAME}]

Parts:
FB2: 330R @ 100MHz; L_0402_1005Metric
J2: JST PH2; JST_PH_S2B-PH-K_1x02_P2.00mm_Horizontal
J3: JST GH2; JST_GH_SM02B-GHS-TB_1x02-1MP_P1.25mm_Horizontal
R8, R9: 100R; R_0402_1005Metric

Connections:
/Battery Charger/TS+: R8.2; also elsewhere on the board
/Battery/BATT_IN: FB2.1, J2.2
/Battery/S_T+: J3.2, R8.1
/Battery/S_T-: J3.1, R9.1
/V_{BAT}: FB2.2; also elsewhere on the board
GND: J2.1, J3.MP, R9.2; also elsewhere on the board

Notes on the sheet:
Meant to be used with B57861S0103F040
Meant to be used with Adafruit 3898 (400mAh LiPo battery)

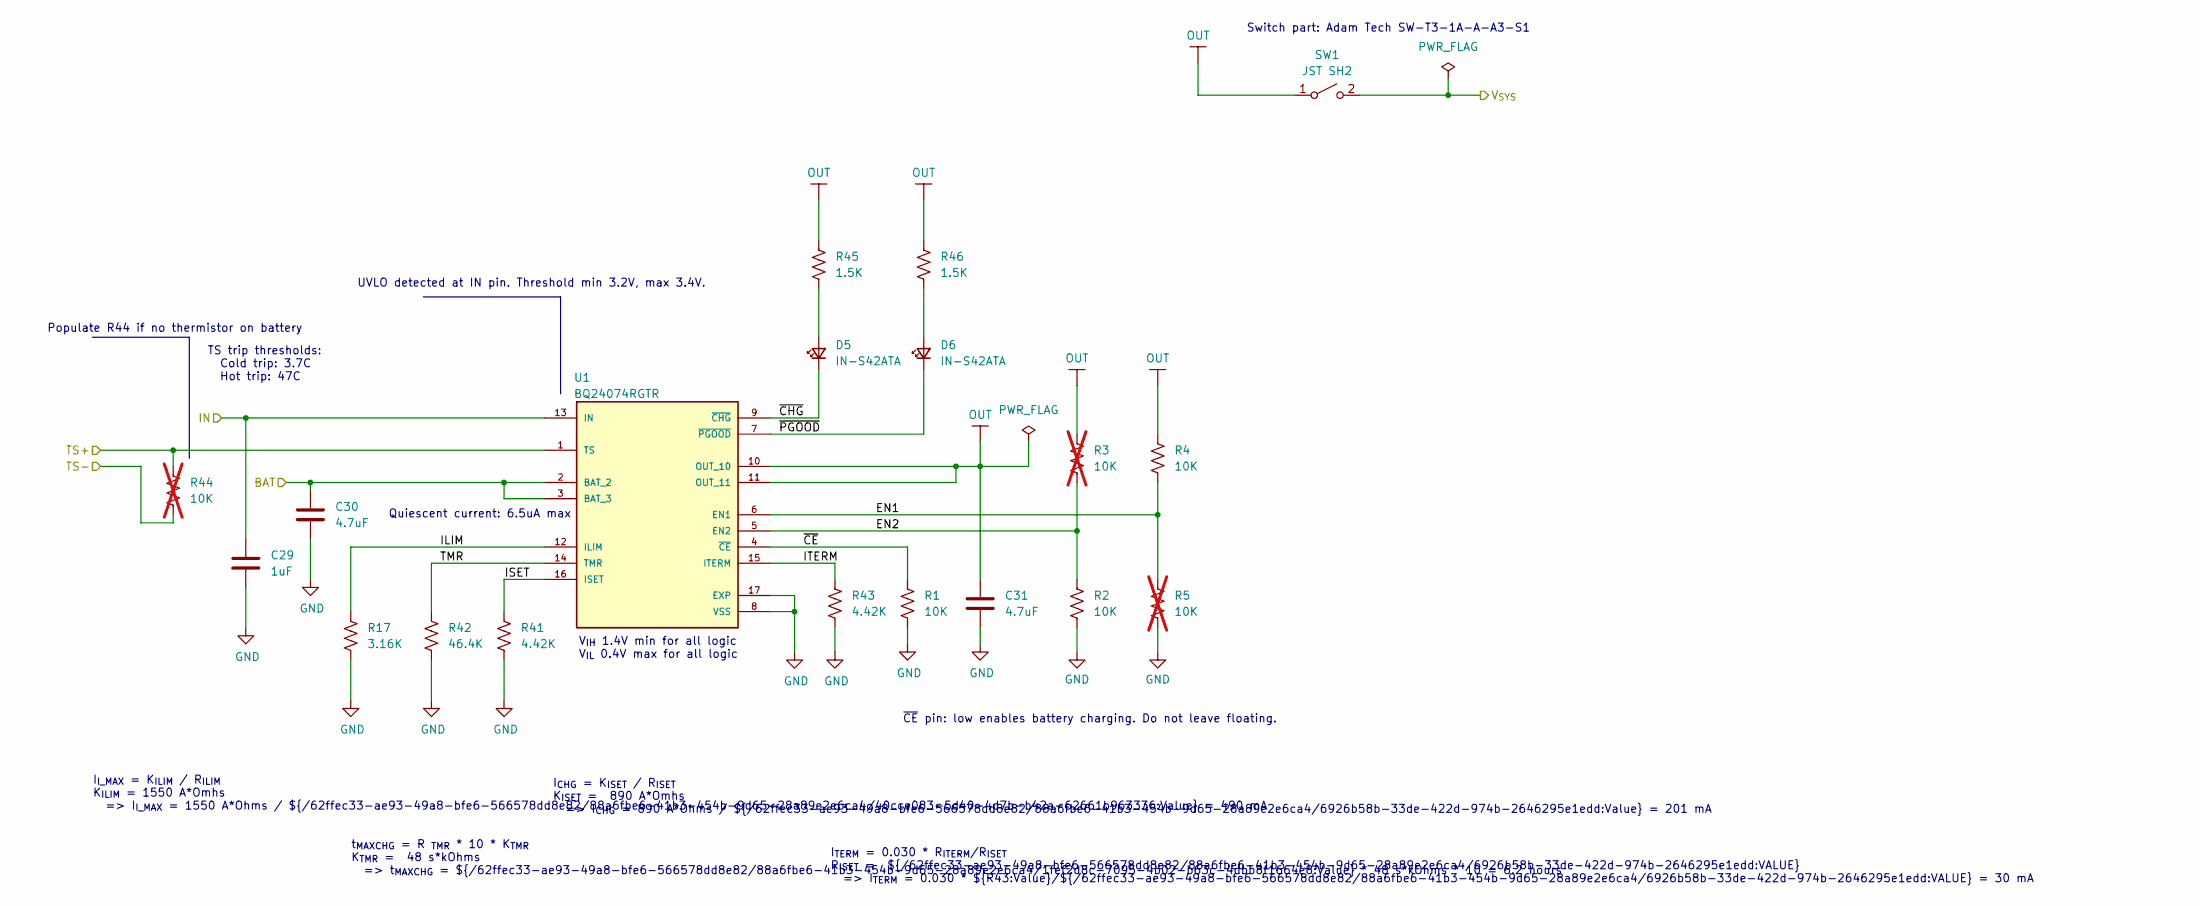
[picture p19: schematic charger.kicad_sch, ${PROJECT_NAME}]

Parts:
C29: 1uF; C_0402_1005Metric
C30, C31: 4.7uF; C_0603_1608Metric
D5, D6: IN-S42ATA; LED_0402_1005Metric
R1, R2, R4: 10K; R_0402_1005Metric
R3, R5, R44: 10K; R_0402_1005Metric; not fitted
R17: 3.16K; R_0402_1005Metric
R41, R43: 4.42K; R_0402_1005Metric
R42: 46.4K; R_0402_1005Metric
R45, R46: 1.5K; R_0402_1005Metric
SW1: JST SH2; JST_SH_BM02B-SRSS-TB_1x02-1MP_P1.00mm_Vertical
U1: BQ24074RGTR; bq24074rgtr

Connections:
/Battery Charger/EN1: R4.2, R5.1, U1.6 (EN1)
/Battery Charger/EN2: R2.1, R3.2, U1.5 (EN2)
/Battery Charger/ILIM: R17.1, U1.12 (ILIM)
/Battery Charger/ISET: R41.2, U1.16 (ISET)
/Battery Charger/ITERM: R43.2, U1.15 (ITERM)
/Battery Charger/OUT: C31.2, R3.1, R4.1, R45.2, R46.2, SW1.1 (A), U1.10 (OUT_10), U1.11 (OUT_11)
/Battery Charger/TMR: R42.2, U1.14 (TMR)
/Battery Charger/TS+: R44.1, U1.1 (TS); also elsewhere on the board
/Battery Charger/~CE: R1.1, U1.4 (~CE)
/Battery Charger/~CHG: D5.1 (K), U1.9 (~CHG)
/Battery Charger/~PGOOD: D6.1 (K), U1.7 (~PGOOD)
/V_{BAT}: C30.2, U1.2 (BAT_2), U1.3 (BAT_3); also elsewhere on the board
/V_{BUS}: C29.2, U1.13 (IN); also elsewhere on the board
/V_{SYS}: SW1.2 (B); also elsewhere on the board
GND: C29.1, C30.1, C31.1, R1.2, R2.2, R5.2, R17.2, R41.1, R42.1, R43.1, R44.2, U1.8 (VSS), U1.17 (EXP); also elsewhere on the board
unnamed: D5.2 (A), R45.1
unnamed: D6.2 (A), R46.1

Notes on the sheet:
~{CE} pin: low enables battery charging. Do not leave floating.
Quiescent current: 6.5uA max
V_{IH} 1.4V min for all logic V_{IL} 0.4V max for all logic
UVLO detected at IN pin. Threshold min 3.2V, max 3.4V.
I_{TERM} = 0.030 * R_{ITERM}/R_{ISET} R_{ISET} = ${/62ffec33-ae93-49a8-bfe6-566578dd8e82/88a6fbe6-41b3-454b-9d65-28a89e2e6ca4/6926b58b-33de-422d-974b-2646295e1edd:VALUE} => I_{TERM} = 0.030 * ${R43:Value}/${/62ffec33-ae93-49a8-bfe6-566578dd8e82/88a6fbe6-41b3-454b-9d65-28a89e2e6ca4/6926b58b-33de-422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
TS trip thresholds: Cold trip: 3.7C Hot trip: 47C
t_{MAXCHG} = R _{TMR} * 10 * K_{TMR} K_{TMR} = 48 s*kOhms => t_{MAXCHG} = ${/62ffec33-ae93-49a8-bfe6-566578dd8e82/88a6fbe6-41b3-454b-9d65-28a89e2e6ca4/1fef2d8c-7095-4b02-b63c-4dbb8f1664e8:Value} * 48 s*kOhms * 10 = 6.2 hours
Switch part: Adam Tech SW-T3-1A-A-A3-S1
I_{I_MAX} = K_{ILIM} / R_{ILIM} K_{ILIM} = 1550 A*Omhs => I_{I_MAX} = 1550 A*Ohms / ${/62ffec33-ae93-49a8-bfe6-566578dd8e82/88a6fbe6-41b3-454b-9d65-28a89e2e6ca4/40cce083-5d40-4d7b-b42a-62661b963336:Value} = 490 mA
Populate R44 if no thermistor on battery
I_{CHG} = K_{ISET} / R_{ISET} K_{ISET} = 890 A*Omhs => I_{CHG} = 890 A*Ohms / ${/62ffec33-ae93-49a8-bfe6-566578dd8e82/88a6fbe6-41b3-454b-9d65-28a89e2e6ca4/6926b58b-33de-422d-974b-2646295e1edd:Value} = 201 mA

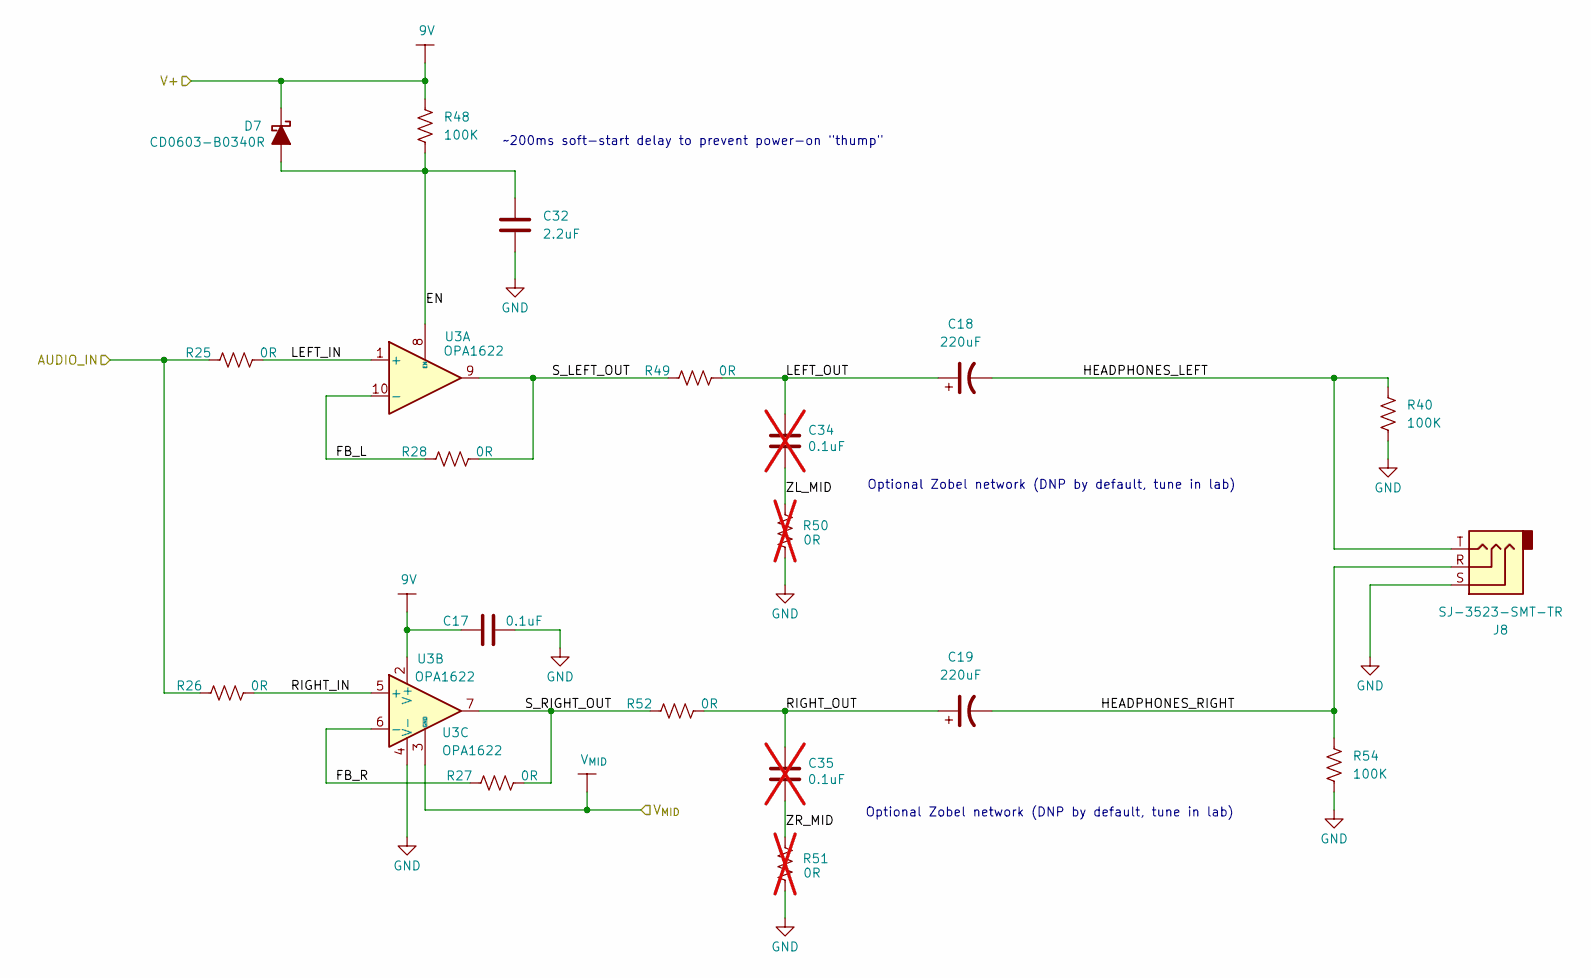
[picture p20: schematic buffer.kicad_sch, ${PROJECT_NAME}]

Parts:
C17: 0.1uF; C_0402_1005Metric
C18, C19: 220uF; WCAP-PSLP_6.3X5.8_DXL_
C32: 2.2uF; C_0603_1608Metric
C34, C35: 0.1uF; C_0402_1005Metric; not fitted
D7: CD0603-B0340R; D_0603_1608Metric
J8: SJ-3523-SMT-TR; Jack_3.5mm_CUI_SJ-3523-SMT_Horizontal
R25, R26, R27, R28, R49, R52: 0R; R_0402_1005Metric
R40, R48, R54: 100K; R_0402_1005Metric
R50, R51: 0R; R_0402_1005Metric; not fitted
U3: OPA1622; Texas_S-PVSON-N10

Connections:
/Audio Input/AUDIO_OUT: R25.1, R26.1; also elsewhere on the board
/Current Buffer/EN: C32.2, D7.2 (A), R48.1, U3.8 (EN)
/Current Buffer/FB_L: R28.1, U3.10 (-)
/Current Buffer/FB_R: R27.1, U3.6 (-)
/Current Buffer/HEADPHONES_LEFT: C18.2, J8.T, R40.1
/Current Buffer/HEADPHONES_RIGHT: C19.2, J8.R, R54.1
/Current Buffer/LEFT_IN: R25.2, U3.1 (+)
/Current Buffer/LEFT_OUT: C18.1, C34.2, R49.2
/Current Buffer/RIGHT_IN: R26.2, U3.5 (+)
/Current Buffer/RIGHT_OUT: C19.1, C35.2, R52.2
/Current Buffer/S_LEFT_OUT: R28.2, R49.1, U3.9
/Current Buffer/S_RIGHT_OUT: R27.2, R52.1, U3.7
/Current Buffer/ZL_MID: C34.1, R50.2
/Current Buffer/ZR_MID: C35.1, R51.2
/V+: C17.1, D7.1 (K), R48.2, U3.2 (V+); also elsewhere on the board
/V_{MID}: U3.3 (GND); also elsewhere on the board
GND: C17.2, C32.1, J8.S, R40.2, R50.1, R51.1, R54.2, U3.4 (V-), U3.11 (V-); also elsewhere on the board

Notes on the sheet:
Optional Zobel network (DNP by default, tune in lab)
~200ms soft-start delay to prevent power-on "thump"

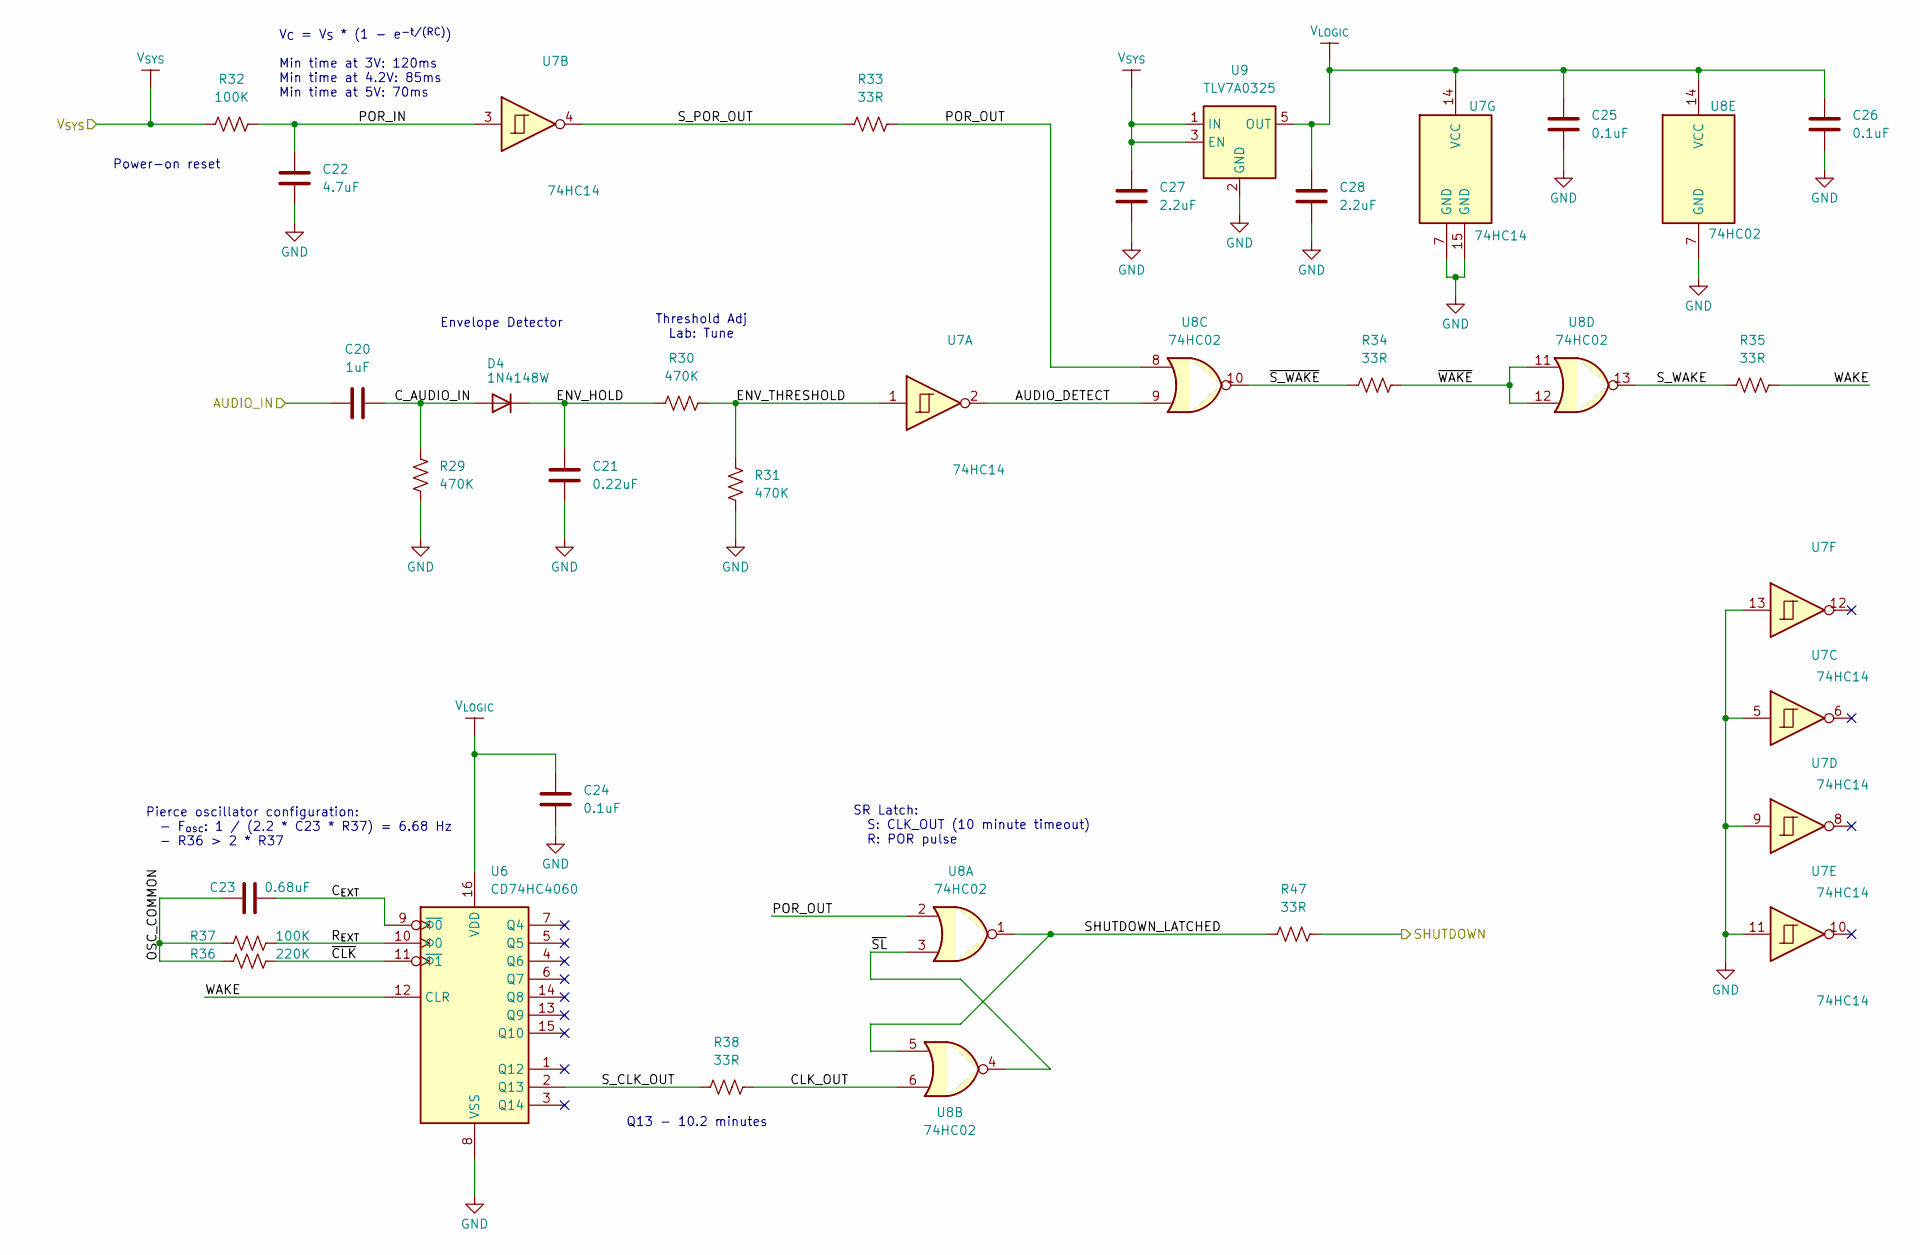
[picture p21: schematic watchdog.kicad_sch, ${PROJECT_NAME}]

Parts:
C20: 1uF; C_0603_1608Metric
C21: 0.22uF; C_0402_1005Metric
C22: 4.7uF; C_0603_1608Metric
C23: 0.68uF; C_0402_1005Metric
C24, C25, C26: 0.1uF; C_0402_1005Metric
C27, C28: 2.2uF; C_0603_1608Metric
D4: 1N4148W; D_SOD-123
R29, R30, R31: 470K; R_0402_1005Metric
R32, R37: 100K; R_0402_1005Metric
R33, R34, R35, R38, R47: 33R; R_0402_1005Metric
R36: 220K; R_0402_1005Metric
U6: CD74HC4060; TSSOP-16_4.4x5mm_P0.65mm
U7: 74HC14; DHVQFN14_SOT762-1_NEX
U8: 74HC02; TSSOP-14_4.4x5mm_P0.65mm
U9: TLV7A0325; SOT-23-5

Connections:
/Audio Input/SECOND_STAGE_OUT: C20.2; also elsewhere on the board
/Boost/SHUTDOWN: R47.1; also elsewhere on the board
/V_{SYS}: C27.2, R32.1, U9.1 (IN), U9.3 (EN); also elsewhere on the board
/Watchdog/AUDIO_DETECT: U7.2, U8.9
/Watchdog/CLK_OUT: R38.1, U8.6
/Watchdog/C_AUDIO_IN: C20.1, D4.2 (A), R29.2
/Watchdog/C_{EXT}: C23.1, U6.9 (~Φ0)
/Watchdog/ENV_HOLD: C21.1, D4.1 (K), R30.2
/Watchdog/ENV_THRESHOLD: R30.1, R31.1, U7.1
/Watchdog/OSC_COMMON: C23.2, R36.2, R37.2
/Watchdog/POR_IN: C22.2, R32.2, U7.3
/Watchdog/POR_OUT: R33.1, U8.2, U8.8
/Watchdog/R_{EXT}: R37.1, U6.10 (Φ0)
/Watchdog/SHUTDOWN_LATCHED: R47.2, U8.1, U8.5
/Watchdog/S_CLK_OUT: R38.2, U6.2 (Q13)
/Watchdog/S_POR_OUT: R33.2, U7.4
/Watchdog/S_WAKE: R35.2, U8.13
/Watchdog/V_{LOGIC}: C24.1, C25.1, C26.1, C28.2, U6.16 (VDD), U7.14 (VCC), U8.14 (VCC), U9.5 (OUT)
/Watchdog/WAKE: R35.1, U6.12 (CLR)
/Watchdog/~CLK: R36.1, U6.11 (~Φ1)
/Watchdog/~SL: U8.3, U8.4
/Watchdog/~S_WAKE: R34.2, U8.10
/Watchdog/~WAKE: R34.1, U8.11, U8.12
GND: C21.2, C22.1, C24.2, C25.2, C26.2, C27.1, C28.1, R29.1, R31.2, U6.8 (VSS), U7.5, U7.7 (GND), U7.9, U7.11, U7.13, U7.15 (GND), U8.7 (GND), U9.2 (GND); also elsewhere on the board

Notes on the sheet:
Envelope Detector
Threshold Adj Lab: Tune
Q13 - 10.2 minutes
Power-on reset
V_{C} = V_{S} * (1 - e^{-t/(RC)}) Min time at 3V: 120ms Min time at 4.2V: 85ms Min time at 5V: 70ms
Pierce oscillator configuration: - F_{osc}: 1 / (2.2 * C23 * R37) = 6.68 Hz - R36 > 2 * R37
SR Latch: S: CLK_OUT (10 minute timeout) R: POR pulse

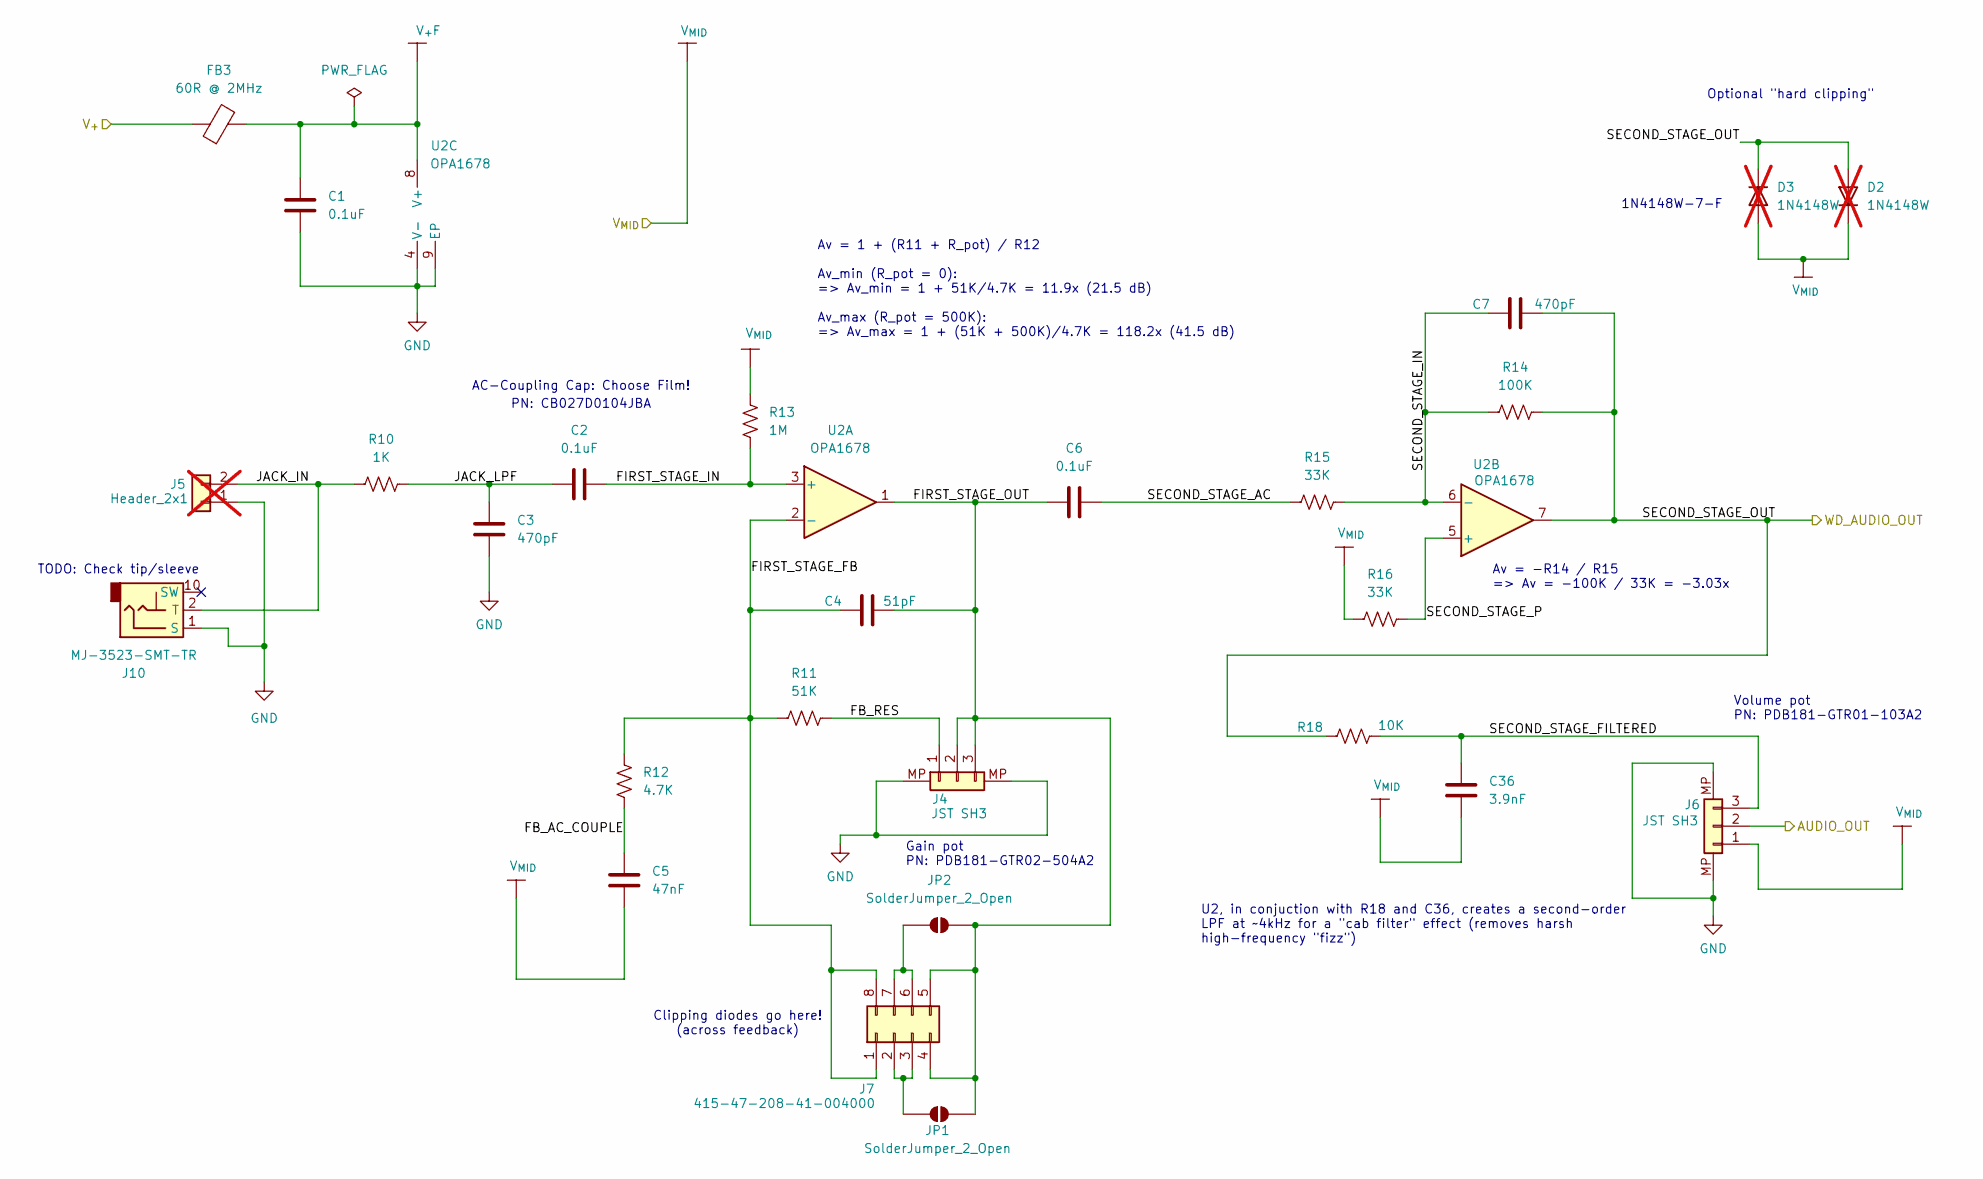
[picture p22: schematic audio_in.kicad_sch, ${PROJECT_NAME}]

Parts:
C1: 0.1uF; C_0402_1005Metric
C2, C6: 0.1uF; C_1210_3225Metric
C3, C7: 470pF; C_0402_1005Metric
C4: 51pF; C_0402_1005Metric
C5: 47nF; C_0402_1005Metric
C36: 3.9nF; C_0603_1608Metric
D2, D3: 1N4148W; D_SOD-123; not fitted
FB3: 60R @ 2MHz; L_Wuerth_PMFI-201610
J4, J6: JST SH3; JST_SH_BM03B-SRSS-TB_1x03-1MP_P1.00mm_Vertical
J5: Header_2x1; PinHeader_2x01_P2.54mm_Vertical; not fitted
J7: 415-47-208-41-004000; PinSocket_2x04_P2.54mm_Vertical
J10: MJ-3523-SMT-TR; CONN_MJ-3523_CUD
JP1, JP2: SolderJumper_2_Open; SolderJumper-2_P1.3mm_Open_TrianglePad1.0x1.5mm
R10: 1K; R_0402_1005Metric
R11: 51K; R_0402_1005Metric
R12: 4.7K; R_0402_1005Metric
R13: 1M; R_0402_1005Metric
R14: 100K; R_0402_1005Metric
R15, R16: 33K; R_0402_1005Metric
R18: 10K; R_0402_1005Metric
U2: OPA1678; DRG0008A

Connections:
/Audio Input/AUDIO_OUT: J6.2; also elsewhere on the board
/Audio Input/FB_AC_COUPLE: C5.1, R12.2
/Audio Input/FB_RES: J4.1, R11.2
/Audio Input/FIRST_STAGE_FB: C4.1, J7.1, J7.8, R11.1, R12.1, U2.2 (-)
/Audio Input/FIRST_STAGE_IN: C2.2, R13.2, U2.3 (+)
/Audio Input/FIRST_STAGE_OUT: C4.2, C6.1, J4.2, J4.3, J7.4, J7.5, JP1.2 (B), JP2.2 (B), U2.1
/Audio Input/JACK_IN: J5.2, J10.2 (T), R10.1
/Audio Input/JACK_LPF: C2.1, C3.1, R10.2
/Audio Input/SECOND_STAGE_AC: C6.2, R15.1
/Audio Input/SECOND_STAGE_FILTERED: C36.1, J6.3, R18.2
/Audio Input/SECOND_STAGE_IN: C7.1, R14.1, R15.2, U2.6 (-)
/Audio Input/SECOND_STAGE_OUT: C7.2, D2.2 (A), D3.1 (K), R14.2, R18.1, U2.7; also elsewhere on the board
/Audio Input/SECOND_STAGE_P: R16.2, U2.5 (+)
/Audio Input/V_{+}F: C1.1, FB3.2, U2.8 (V+)
/V+: FB3.1; also elsewhere on the board
/V_{MID}: C5.2, C36.2, D2.1 (K), D3.2 (A), J6.1, R13.1, R16.1; also elsewhere on the board
GND: C1.2, C3.2, J4.MP, J5.1, J6.MP, J10.1 (S), U2.4 (V-), U2.9 (EP); also elsewhere on the board
unnamed: J7.2, J7.3, JP1.1 (A)
unnamed: J7.6, J7.7, JP2.1 (A)

Notes on the sheet:
PN: CB027D0104JBA
Optional "hard clipping"
Gain pot PN: PDB181-GTR02-504A2
Volume pot PN: PDB181-GTR01-103A2
AC-Coupling Cap: Choose Film!
Clipping diodes go here! (across feedback)
U2, in conjuction with R18 and C36, creates a second-order LPF at ~4kHz for a "cab filter" effect (removes harsh high-frequency "fizz")
Av = -R14 / R15 => Av = -100K / 33K = -3.03x
1N4148W-7-F
TODO: Check tip/sleeve
Av = 1 + (R11 + R_pot) / R12 Av_min (R_pot = 0): => Av_min = 1 + 51K/4.7K = 11.9x (21.5 dB) Av_max (R_pot = 500K): => Av_max = 1 + (51K + 500K)/4.7K = 118.2x (41.5 dB)

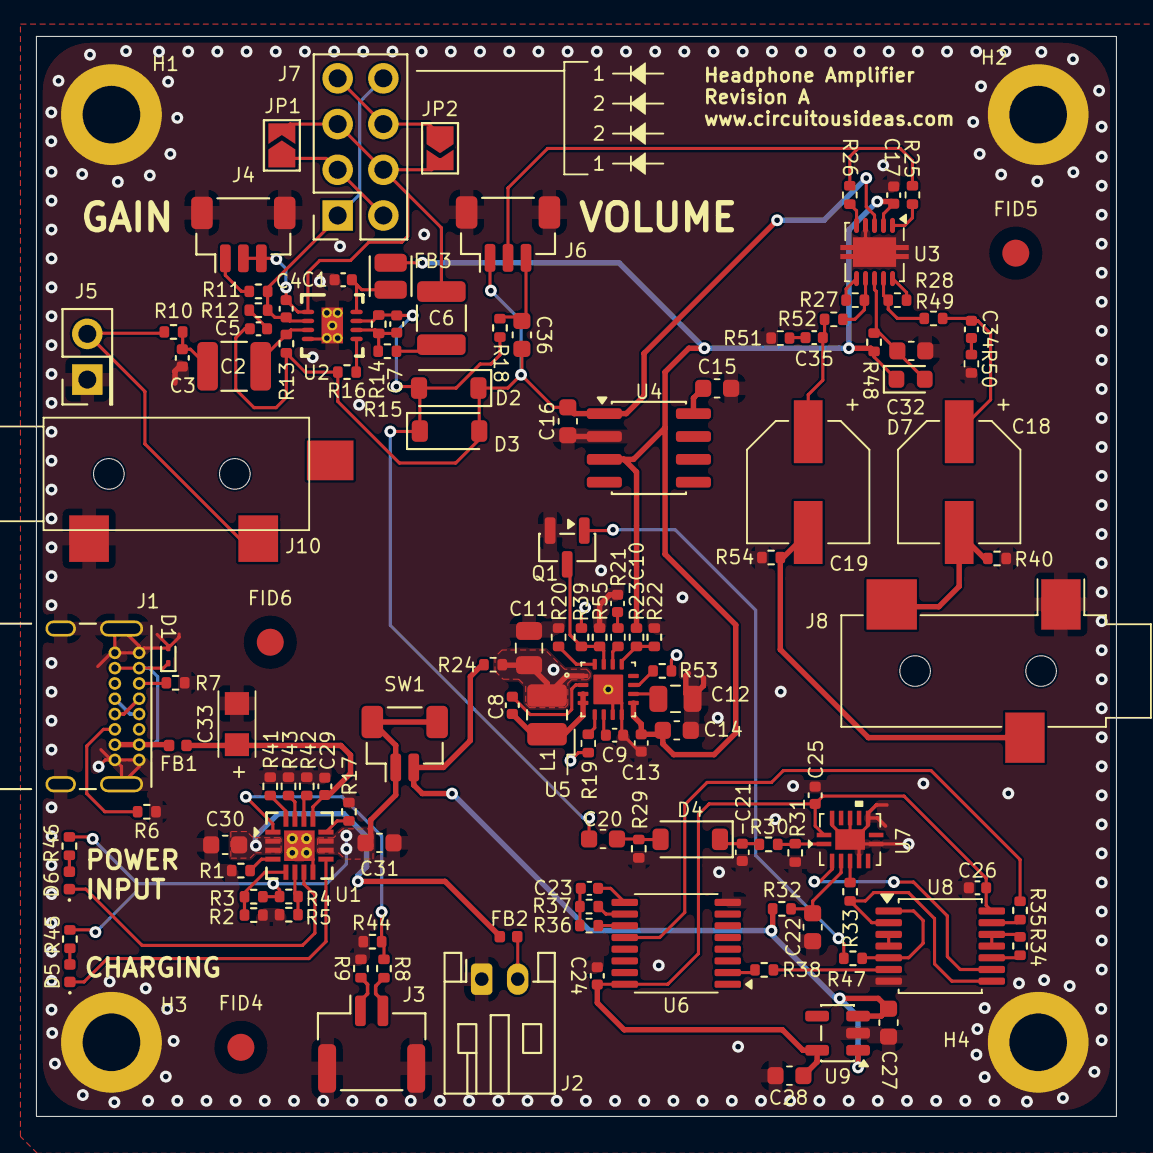
[picture p23: board headphone_amp.kicad_pcb from above]

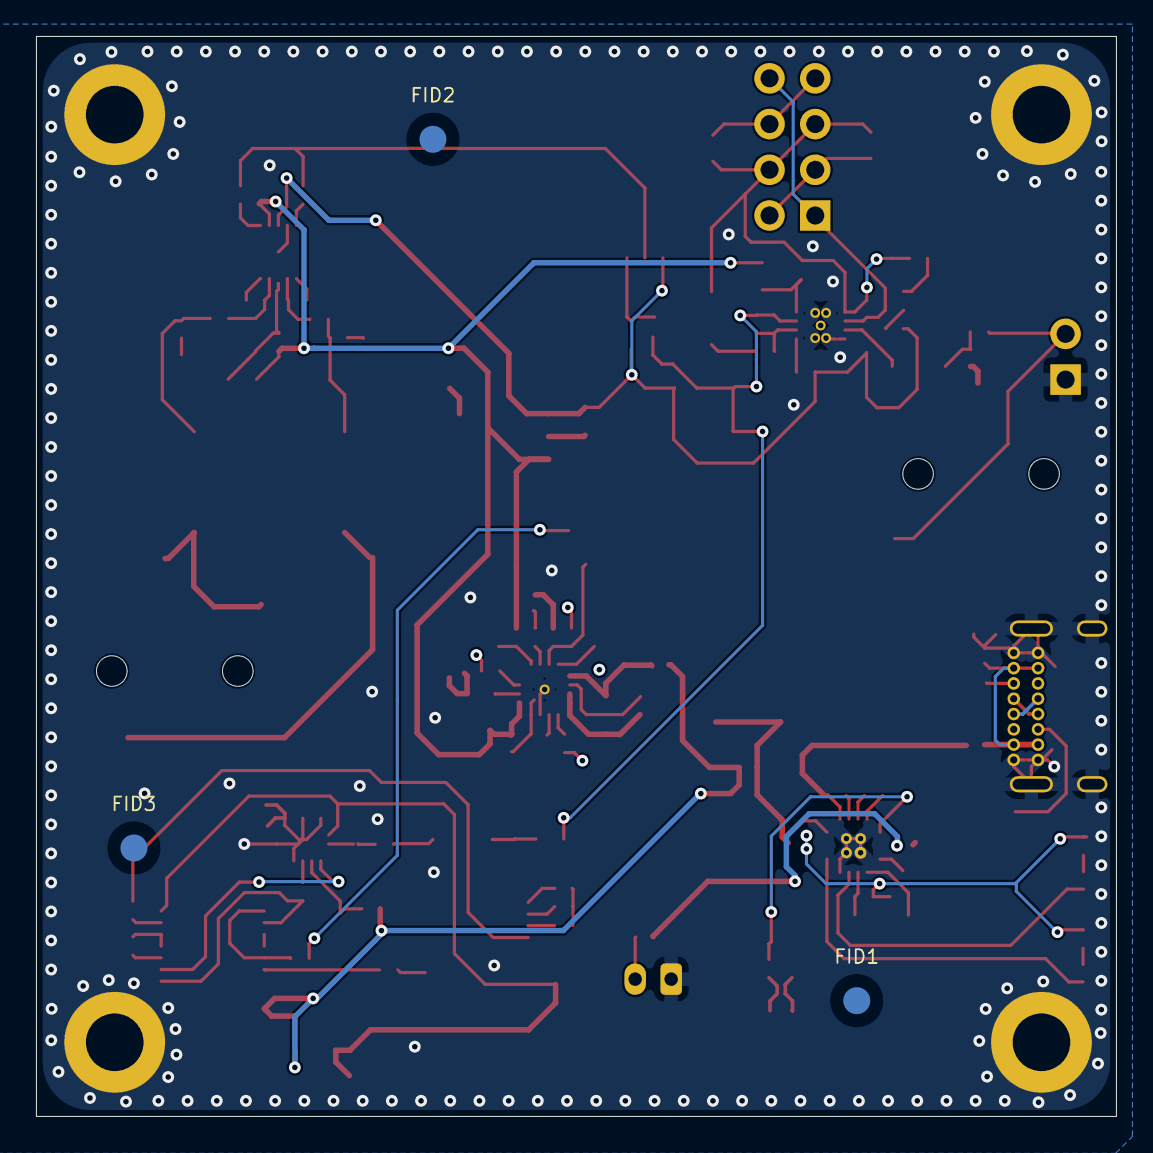
[picture p24: board headphone_amp.kicad_pcb from below]

Board: 4 copper layers, 60.0 x 60.0 mm, 134 parts (3 on the bottom side), 90 nets.
