DSeabra/headphone_amp/(commit log)

2026-08-15 initial commit.
    [charger.kicad_sch, headphone_amp.kicad_pcb, headphone_amp.kicad_sch]
2026-08-15 Added USB power input and battery connector.
    [battery.kicad_sch, headphone_amp.kicad_sch, power_input.kicad_sch]
2026-08-16 Started working on the audio input, including a rough-draft of the first stage.
    [audio_in.kicad_sch, battery.kicad_sch, charger.kicad_sch, headphone_amp.kicad_pcb, headphone_amp.kicad_sch, power_input.kicad_sch]
2026-08-16 Finished second stage, added diode clipping options, and started current buffer.
    [audio_in.kicad_sch, buffer.kicad_sch, headphone_amp.kicad_pcb, headphone_amp.kicad_sch]
2026-08-17 Added notes and started work on boost converter.
    [audio_in.kicad_sch, boost.kicad_sch, charger.kicad_sch, headphone_amp.kicad_pcb, headphone_amp.kicad_sch]
2026-08-25 Implemented boost stage and now working on schematics for current buffers and rail splitter.
    [audio_in.kicad_sch, battery.kicad_sch, boost.kicad_sch, buffer.kicad_sch, charger.kicad_sch, headphone_amp.kicad_sch, power_input.kicad_sch, rail_splitter.kicad_sch]
2026-08-25 Started working on watchdog circuit.
    [audio_in.kicad_sch, boost.kicad_sch, buffer.kicad_sch, watchdog.kicad_sch]
2026-08-28 Finalizing watchdog and boost circuit.
    [boost.kicad_sch, charger.kicad_sch, headphone_amp.kicad_sch, watchdog.kicad_sch]
2026-08-29 First rough draft of schematics complete -- missing a lot of PLM/Inventree work. Ran through several Claude reviews.
    [boost.kicad_sch, buffer.kicad_sch, charger.kicad_sch, headphone_amp.kicad_pcb, headphone_amp.kicad_sch, power_input.kicad_sch, rail_splitter.kicad_sch, watchdog.kicad_sch]
2026-08-29 Small tunes and adjustments before Inventree work.
    [audio_in.kicad_sch, battery.kicad_sch, boost.kicad_sch, buffer.kicad_sch, charger.kicad_sch, headphone_amp.kicad_sch, power_input.kicad_sch, rail_splitter.kicad_sch]
2026-08-29 Started Inventree work.
    [boost.kicad_sch, buffer.kicad_sch, headphone_amp.kicad_pcb, headphone_amp.kicad_sch, watchdog.kicad_sch]
2026-08-30 Corrected issues Claude identified, added 'poor man's cab filter' on recovery stage per Ihsan.
    [audio_in.kicad_sch, boost.kicad_sch, buffer.kicad_sch, headphone_amp.kicad_sch]
2026-08-30 Added schottky symbol in inventree and category to kicad categories.
    [buffer.kicad_sch]
2026-08-31 Started adding new parts to inventree and re-synchronizing here.
    [audio_in.kicad_sch, boost.kicad_sch, charger.kicad_sch, watchdog.kicad_sch]
2026-08-31 Updated theory doc, started layout, fixed a footprint.
    [audio_in.kicad_sch, buffer.kicad_sch, charger.kicad_sch, headphone_amp.kicad_pcb]
2026-09-27 Preliminary layout complete, done on airpane so needs verification.
    [audio_in.kicad_sch, battery.kicad_sch, boost.kicad_sch, buffer.kicad_sch, charger.kicad_sch, headphone_amp.kicad_pcb, headphone_amp.kicad_sch, rail_splitter.kicad_sch]
2026-09-27 Started adding some 3D models and footprints.
    [audio_in.kicad_sch, headphone_amp.kicad_pcb, power_input.kicad_sch, watchdog.kicad_sch]
2026-09-28 Added via stitching.
    [buffer.kicad_sch, headphone_amp.kicad_pcb, headphone_amp.kicad_sch, watchdog.kicad_sch]
2026-09-29 Picked off the board parts and ordered on DigiKey -- also added notes on schematic.
    [audio_in.kicad_sch, battery.kicad_sch, buffer.kicad_sch, charger.kicad_sch, headphone_amp.kicad_pcb, power_input.kicad_sch, watchdog.kicad_sch]
2026-09-30 Finilizing DRC and ERC
    [audio_in.kicad_sch, boost.kicad_sch, charger.kicad_sch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]
2026-10-11 Added dimensions, logo, and silkscreen information.
2026-10-12 Worked with Claude to check BOM, prepare InvenTree import files.
2026-10-19 Finally updated all parts in InvenTree and linked them with KiCAD. Ready for BOM exports to JLC.
